cloudn1ne/Mowgli/Mounting/README.md

## Mounting hardware inside the Bot

### Raspberry Pi 4

* [Raspi 4 Mount STL + Images](./Raspi)

### Meanwell NID65-5 DCDC

* [DCDC Converter mount and wiring](./DCDC)

### UBlox Antenna for RTK GPS
(note that i removed the magnet from the base, to make life easier for the IMUs magnetometer - see pictures in the folder)
You can use the drill template (PDF) with an Eurocard singled sided copper PCB (100x160mm)

* [UBlox GPS Antenna + Drill Template](./GPS%20Antenna)

### Pololu IMU-10-v5

* [IMU Mount STL + Images](./IMU)

### ST-Link

* [ST Link Mount STL + Image](./STLink)

### Cameras (optional)

* [Fish Eye Raspi Cam](./Cam)
* [alternative Fish Eye Raspi Cam](./Cam%20alternative)

## Overview
