cloudn1ne/Mowgli/FlowCharts/README.md

# Mowgli Behavior Flow Charts

You can use [Draw.IO](https://draw.io) to view those files.
