cloudn1ne/Mowgli/Kicad/README.md

## System Architecture 

This Kicad project tracks the system architecture of the GForce mainboard, note that there a sub sheets for every major component on the mainboard.

[Here](https://www.re-innovation.co.uk/docs/multiple-sheet-schematics-in-kicad/) is how that works in case you never used that before.
