cloudn1ne/Mowgli/Mounting/Cam alternative/README.md

## Cam mount (alternative with bigger cam module)

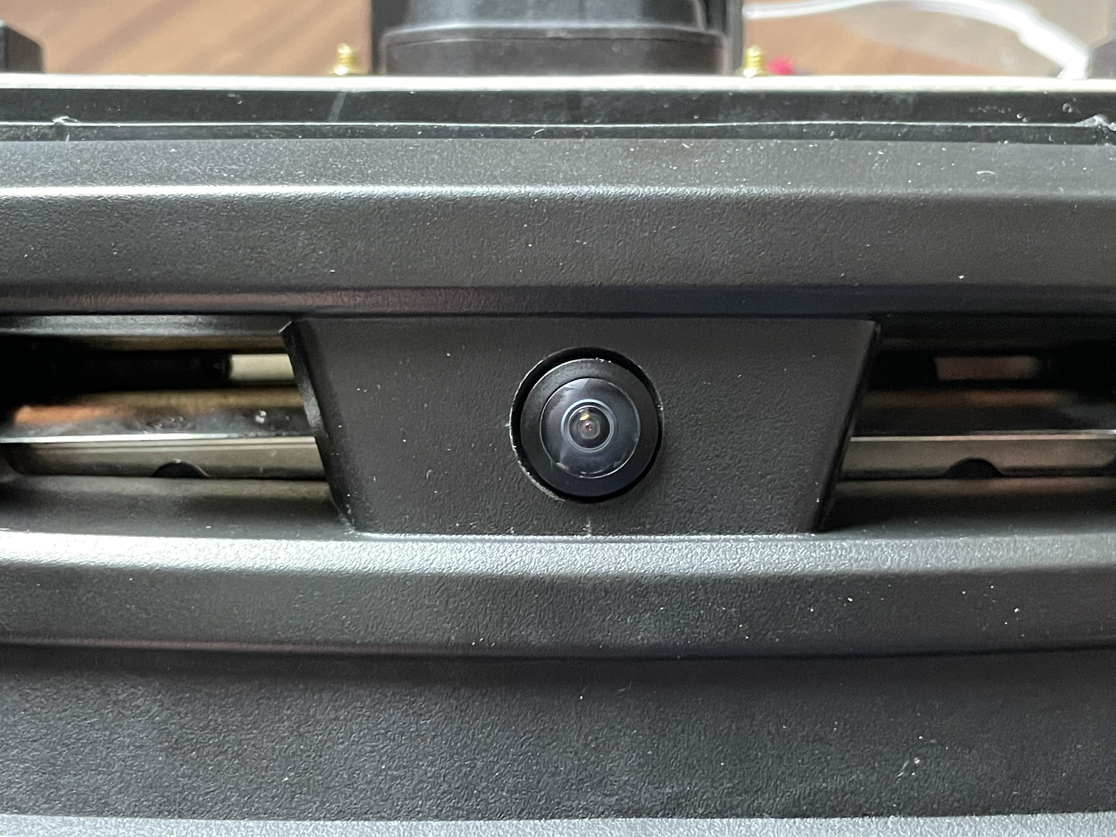
[picture p5: Mounting/Cam alternative/cam_mounted.jpeg]


## Assembly

Used camera was: https://www.amazon.de/gp/product/B074W6TPHF 
(don't forget to additionally purchase a ~50cm camera cable as the one that comes with the camera is just 15cm. I used this one: https://www.amazon.de/gp/product/B01MU2HAOM)

You will need a Dremel tool to slit the case to allow the flat cable to pass through and a 14mm drill for the camera lens to fit through the insert. To mount the camera with the insert to the mount you'll need some M2x14 screws and nuts.

Note that you can remove the whole insert to make drilling and assembly easier.

* Parts

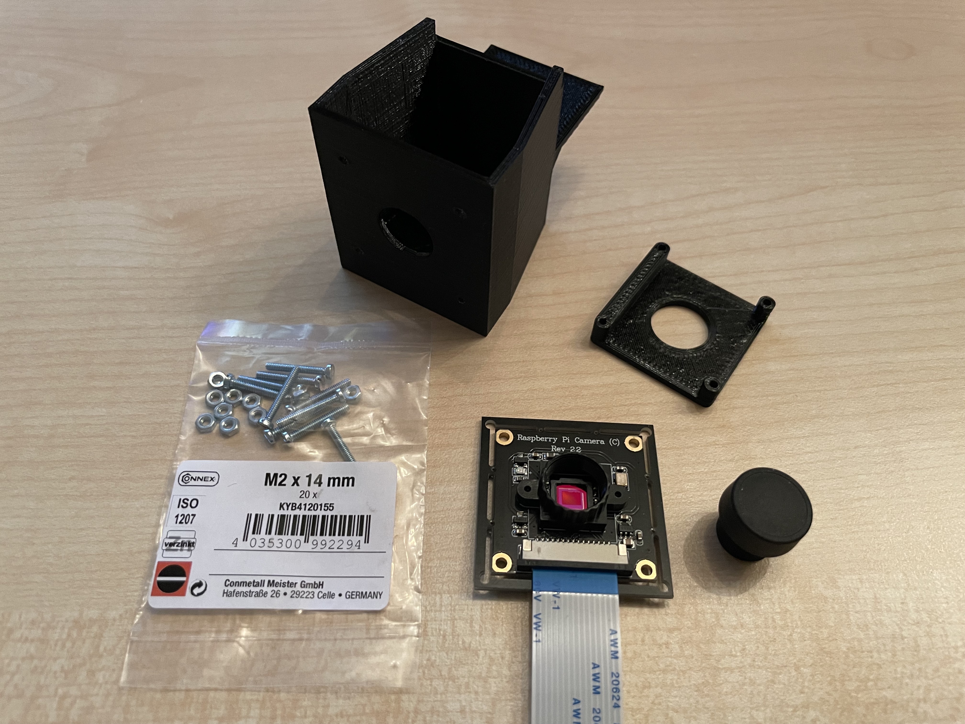
[picture p6: Mounting/Cam alternative/cam_parts.jpeg]


* Mount cam in insert

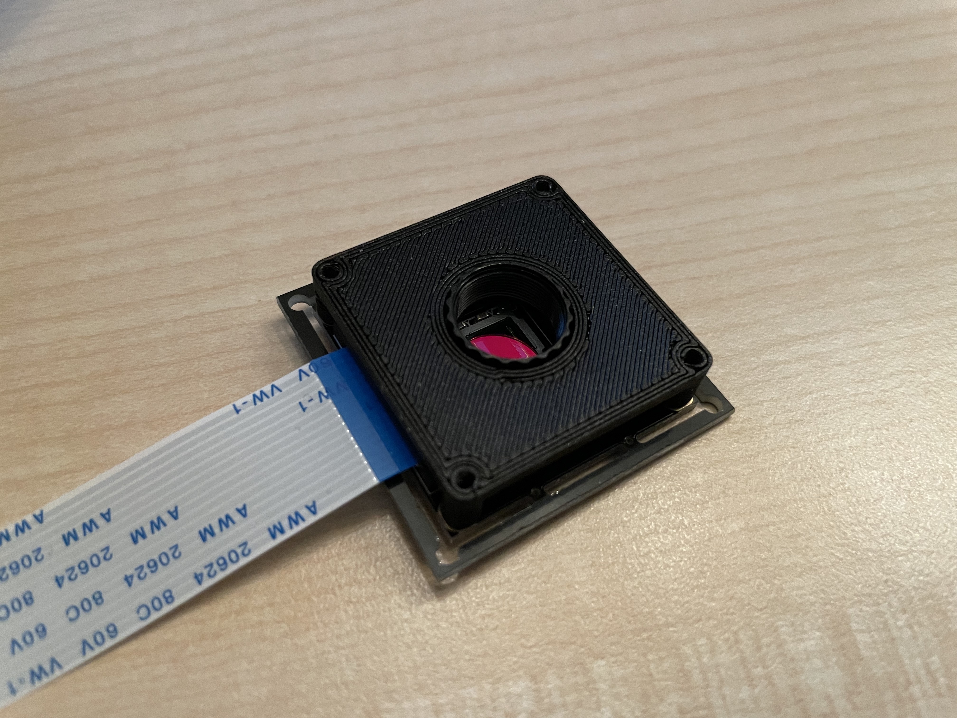
[picture p7: Mounting/Cam alternative/cam_insert.jpeg]


* Mount insert with cam in mount

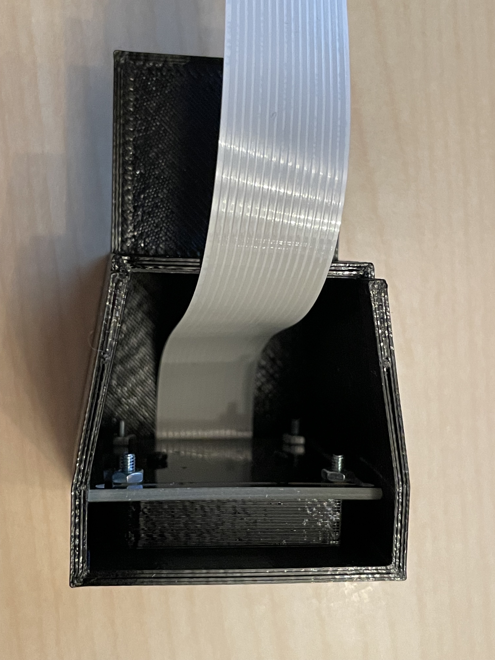
[picture p8: Mounting/Cam alternative/cam_insert_and_mount.jpeg]

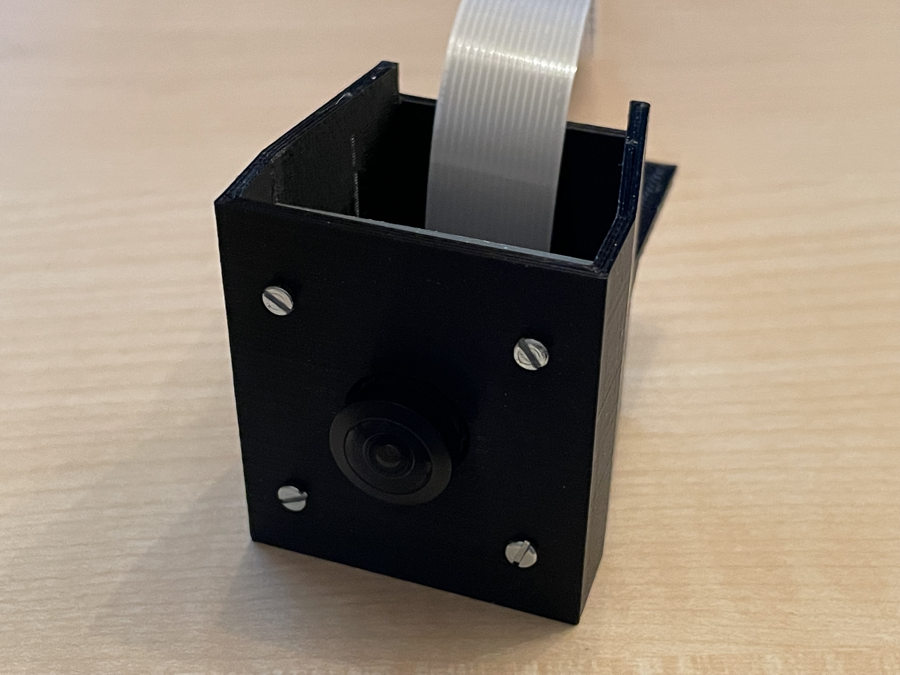
[picture p9: Mounting/Cam alternative/cam_complete.jpeg]


* Make slot with Dremel tool for flat cable

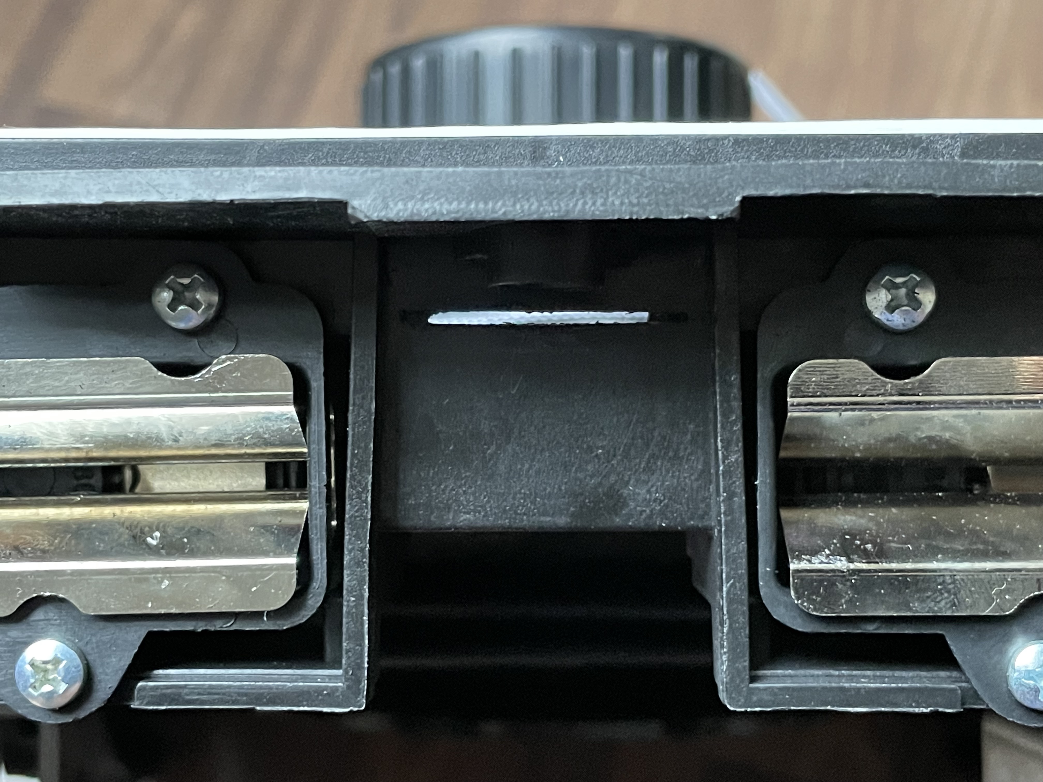
[picture p10: Mounting/Cam alternative/cam_yf500_slot.jpeg]


* Drill out insert with 14mm drill for camera lens

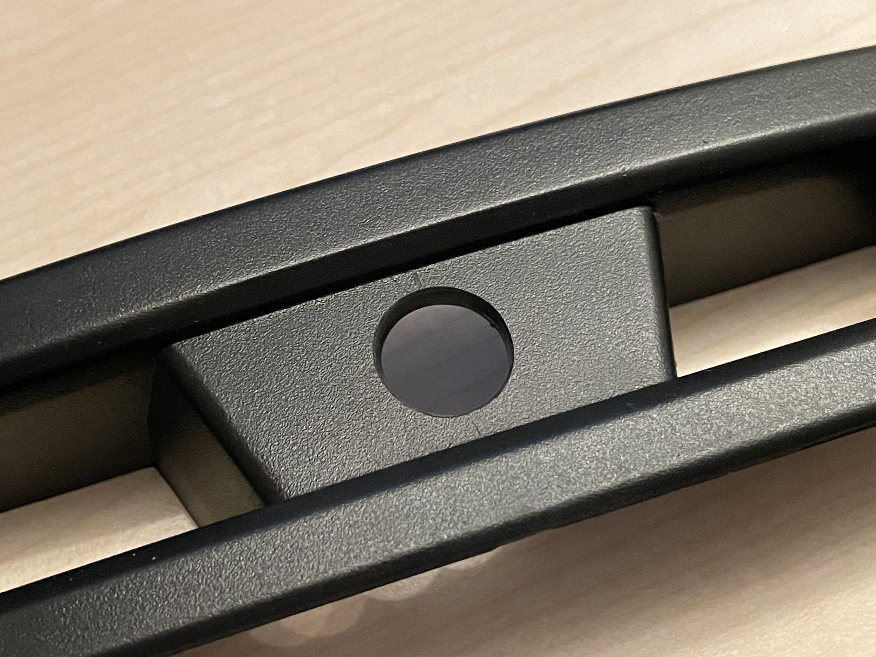
[picture p11: Mounting/Cam alternative/cam_yf500_drill.jpeg]


* Route flat cable through slot to Raspi

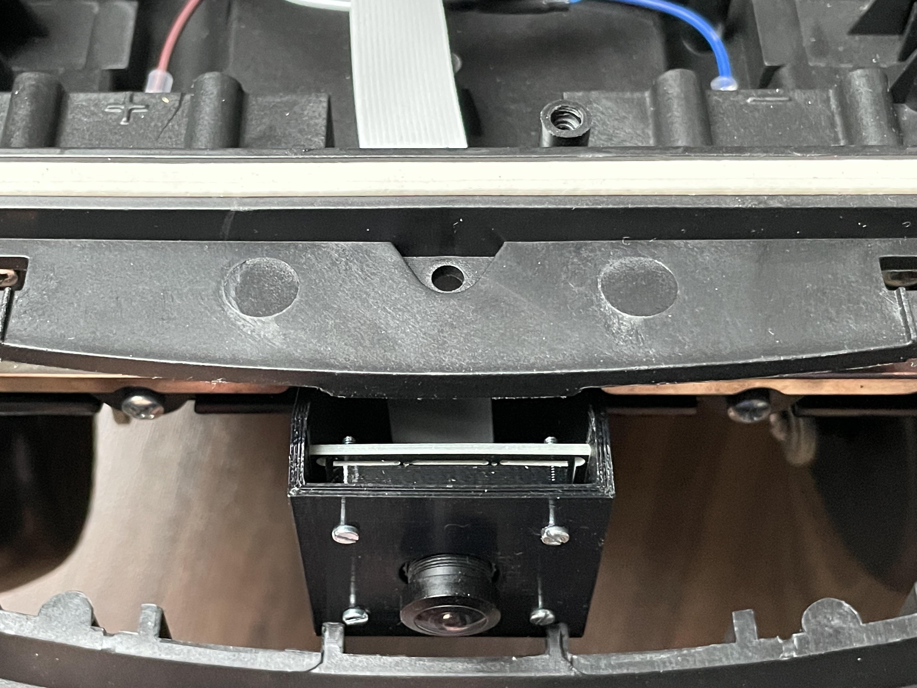
[picture p12: Mounting/Cam alternative/cam_cable_routing.jpeg]
