cloudn1ne/Mowgli/Mounting/Cam/README.md

## Cam mount

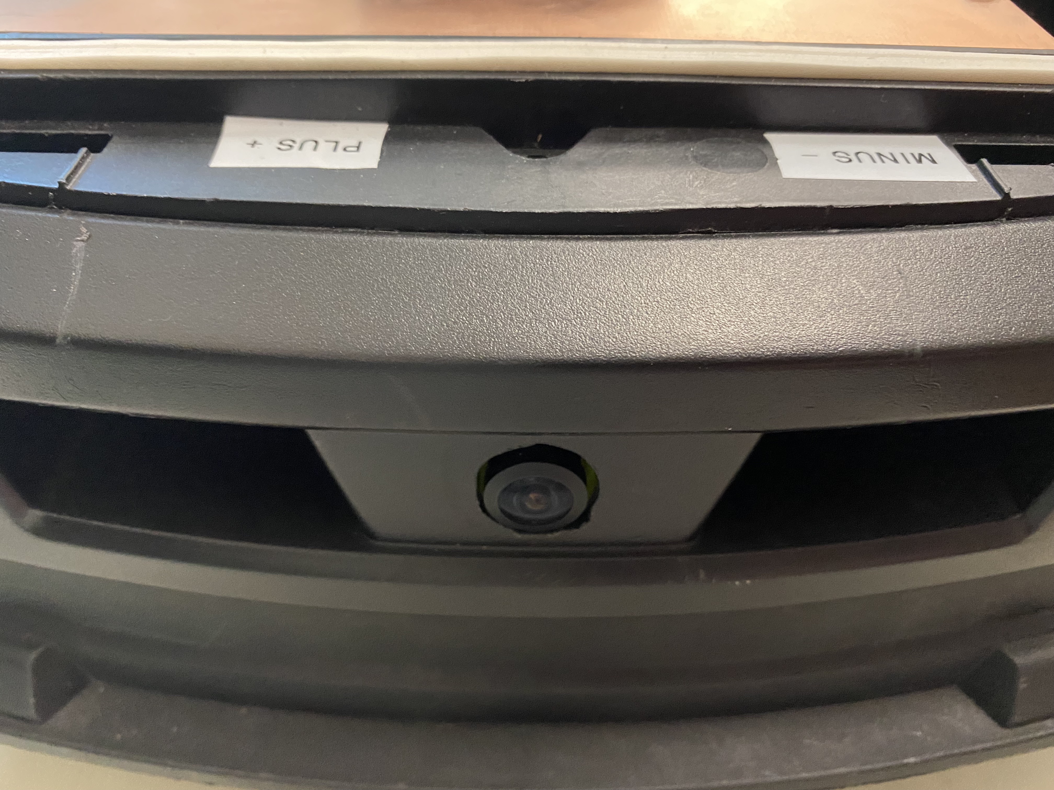
[picture p13: Mounting/Cam/cam_mounted.jpg]


## Assembly

Used camera was: https://www.amazon.com/SainSmart-Fish-Eye-Camera-Raspberry-Arduino/dp/B00N1YJKFS

(For an alternative mount for bigger cam modules see [here](../Cam%20alternative/))

You will need a dreml to slit the case to allow the flat flex to pass through and a 14mm drill

Note that you can remove the whole insert to make drilling and assembly easier.

* Mount cam in insert

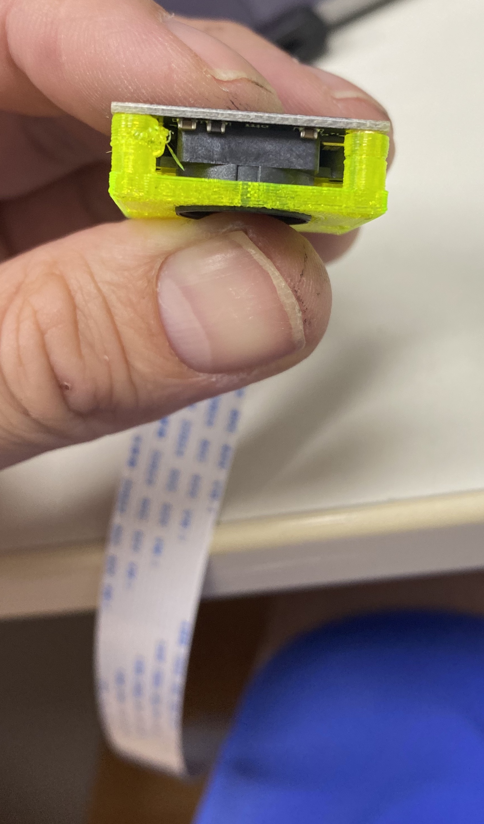
[picture p14: Mounting/Cam/cam_insert.jpg]


* Mount insert in mount

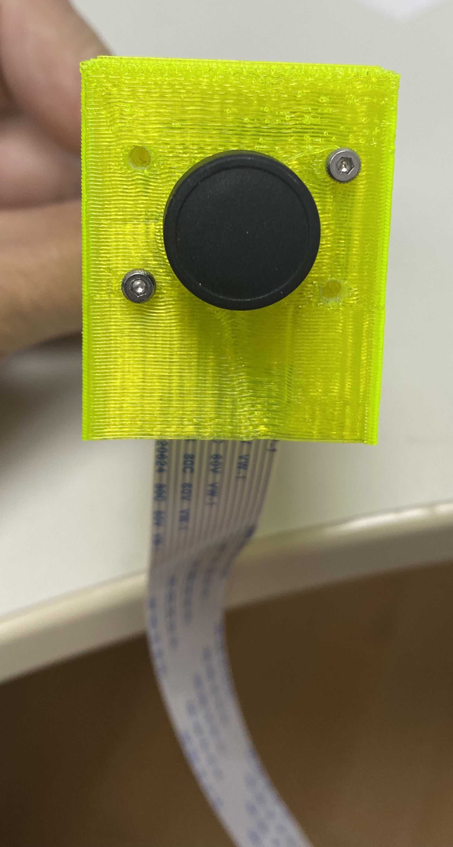
[picture p15: Mounting/Cam/cam_insert_and_mount2.jpg]

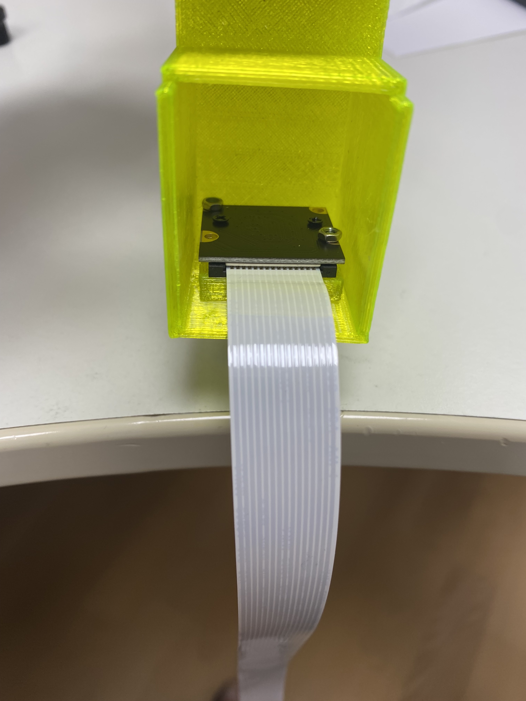
[picture p16: Mounting/Cam/cam_insert_and_mount1.jpg]


* Make slit with dremel for flatflex
* Route flatflex to raspi

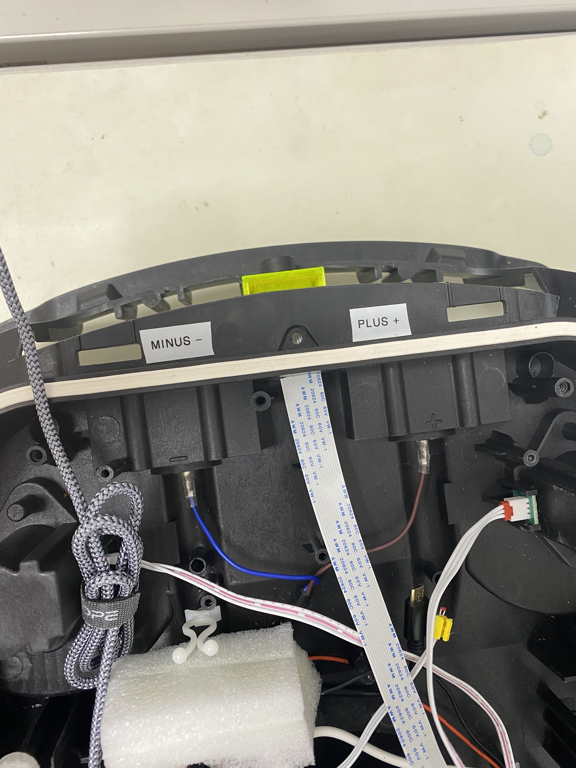
[picture p17: Mounting/Cam/cam_cable_routing.jpg]
