cloudn1ne/Mowgli/Mounting/GPS Antenna/README.md

## Mounting

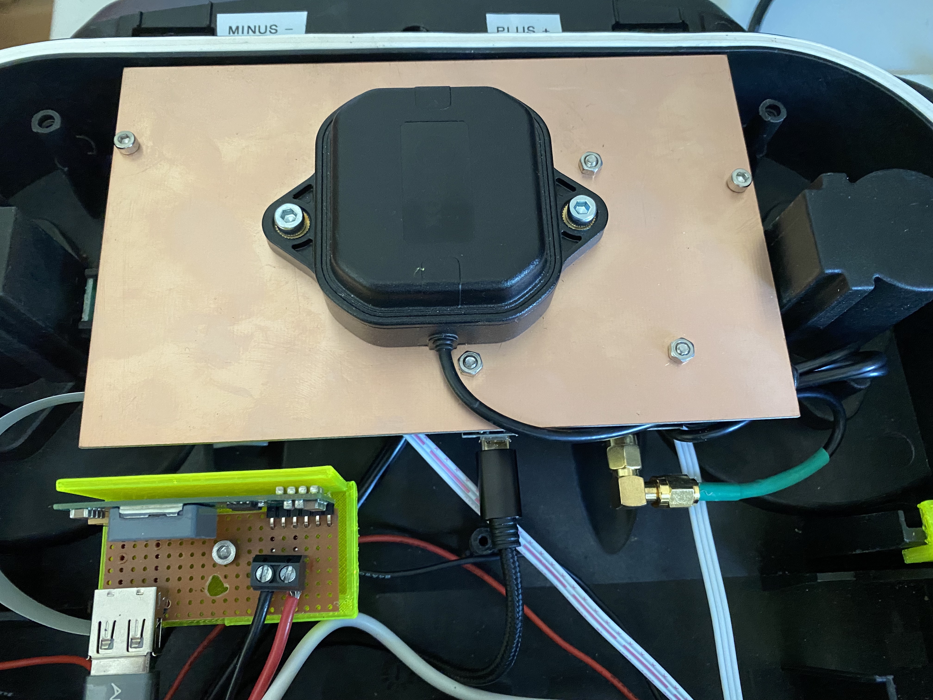
[picture p19: Mounting/GPS Antenna/ublox_mounting.jpg]


## Remove the magnet from the base of the UBlox Antenna

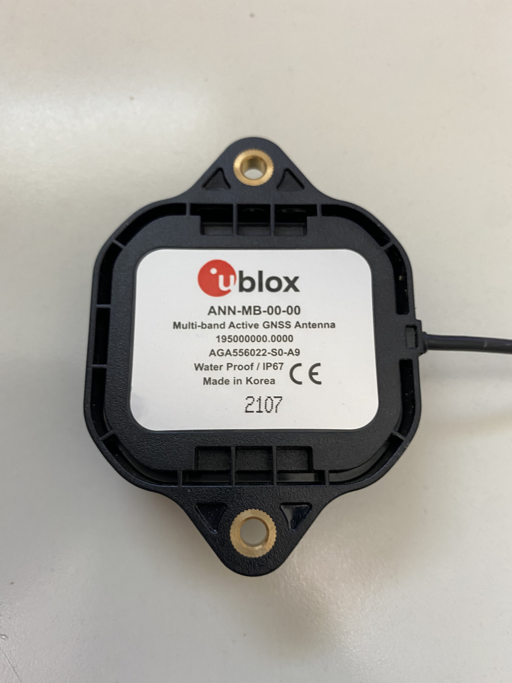
[picture p20: Mounting/GPS Antenna/ublox_mag_removal1.jpg]

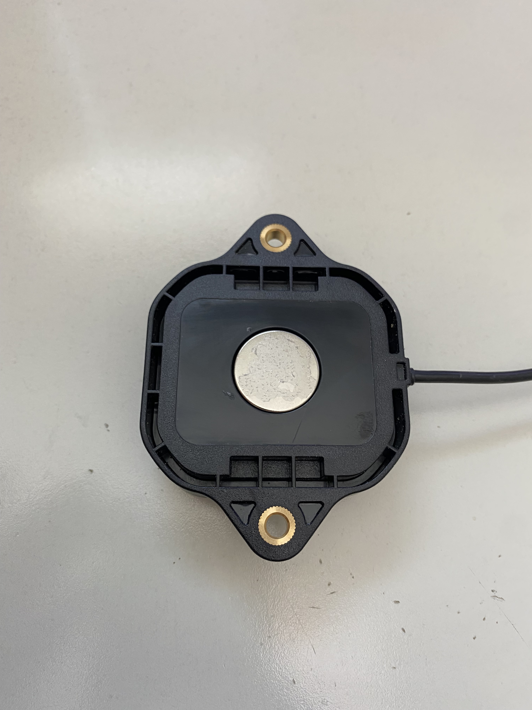
[picture p21: Mounting/GPS Antenna/ublox_mag_removal2.jpg]

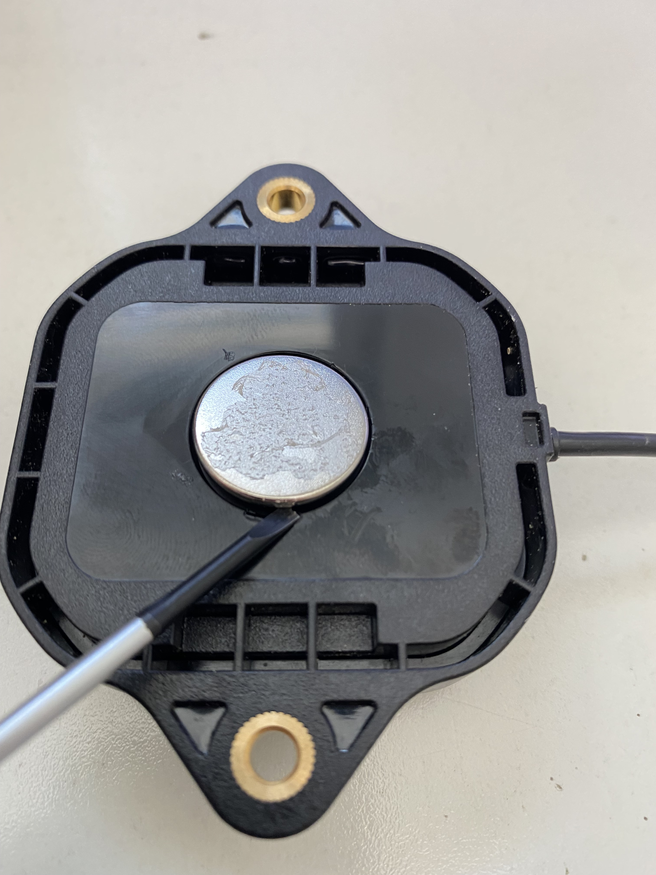
[picture p22: Mounting/GPS Antenna/ublox_mag_removal3.jpg]

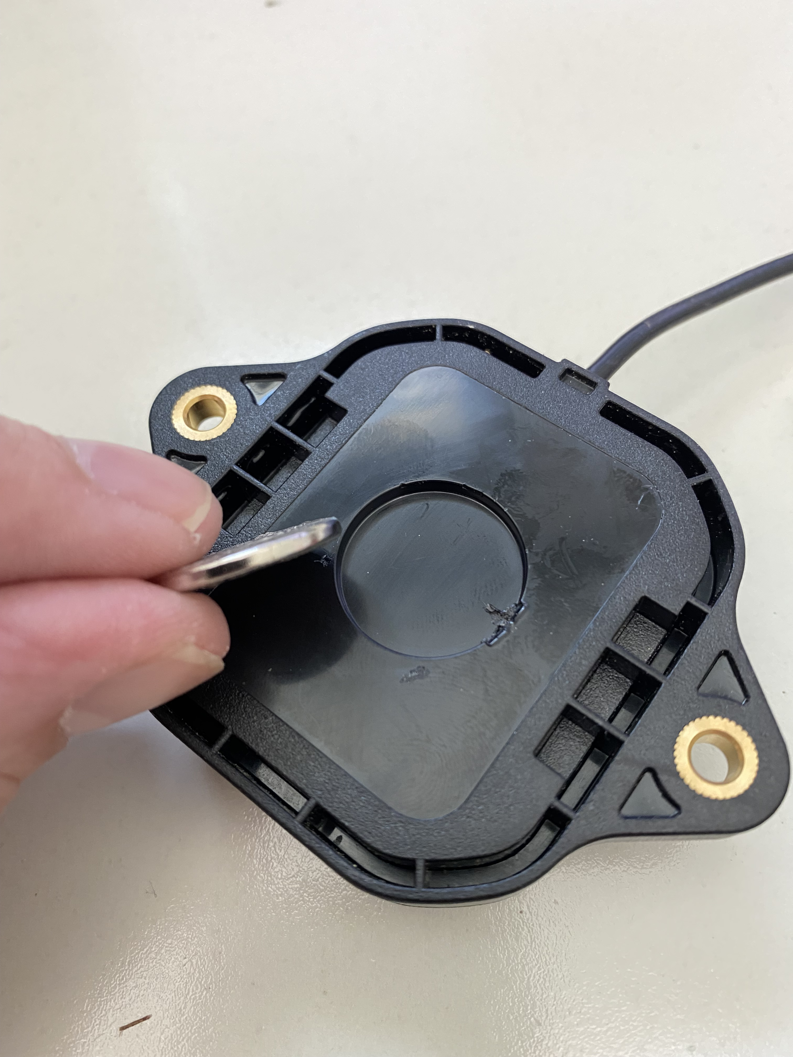
[picture p23: Mounting/GPS Antenna/ublox_mag_removal4.jpg]
