cloudn1ne/Mowgli/Mounting/STLink/README.md

## ST Link mounting

Be carefull when you close the lid, it is a tight fit

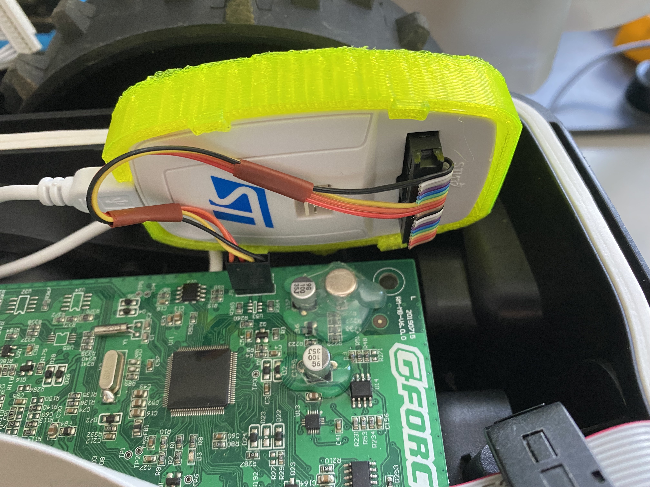
[picture p24: Mounting/STLink/stlink_mounted.jpg]
