cloudn1ne/Mowgli/Mounting/IMU/README.md

## External (Debug) Serial & optionally IMU

## Refurbish the existing sensor board cable shown here:

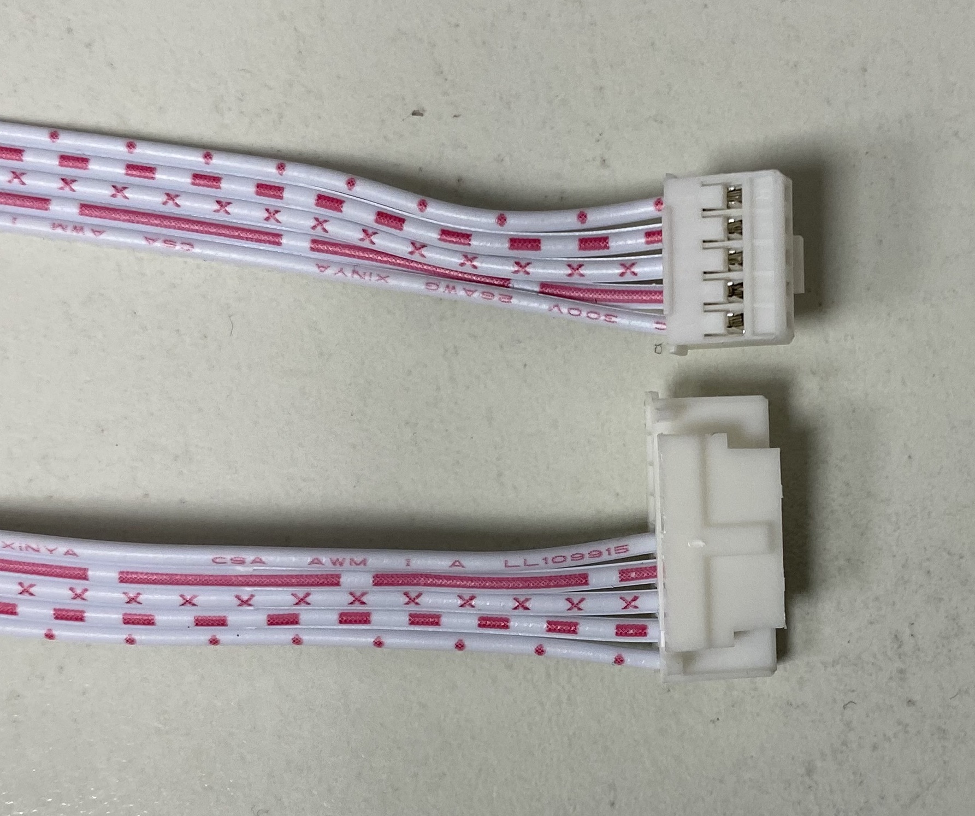
[picture p25: Mounting/IMU/serial_and_i2c_orig.jpg]


## And refactor to an Debug and IMU (I2C) cable:

You will need to relocate the pins using a sharp pick tool (gently lift the small plastic tab, then you can extract the individual crimp pins, slide them into the new position until u hear an audible click)

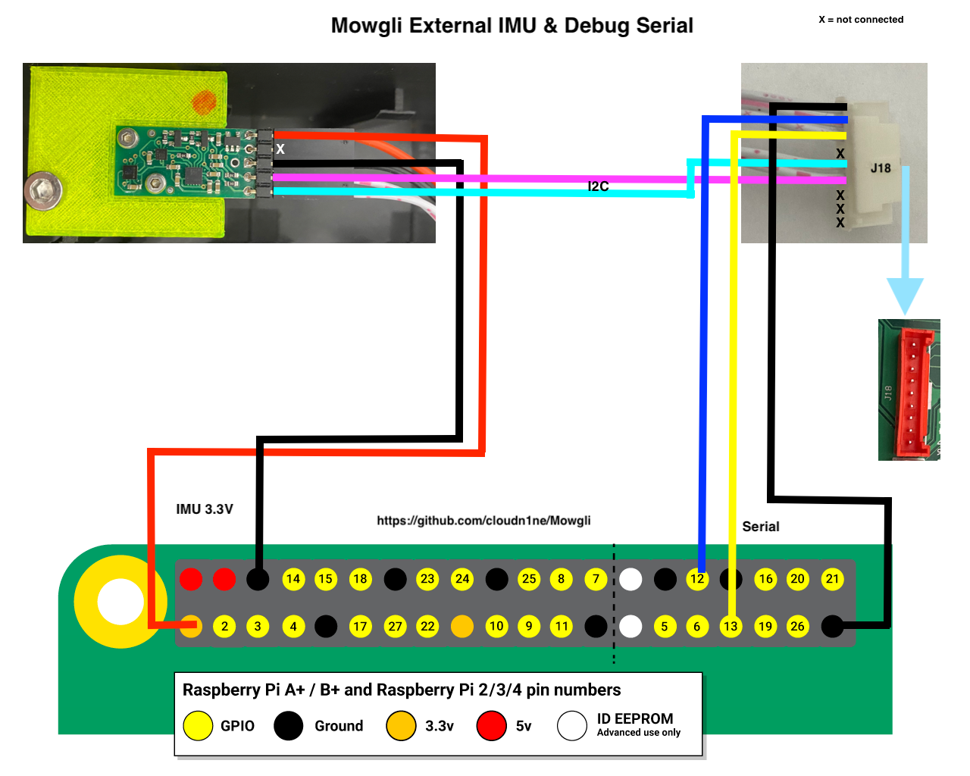
[picture p26: Mounting/IMU/serial_and_i2c_mowgli.png]


If you do not need the I2C IMU you can obmit those cables, and just connect Black (GND), Blue (TX), Yellow (RX) to the Raspi GPIO header

## IMU Mounting location
