cloudn1ne/Mowgli/Datasheets/Mowgli_Battery.png

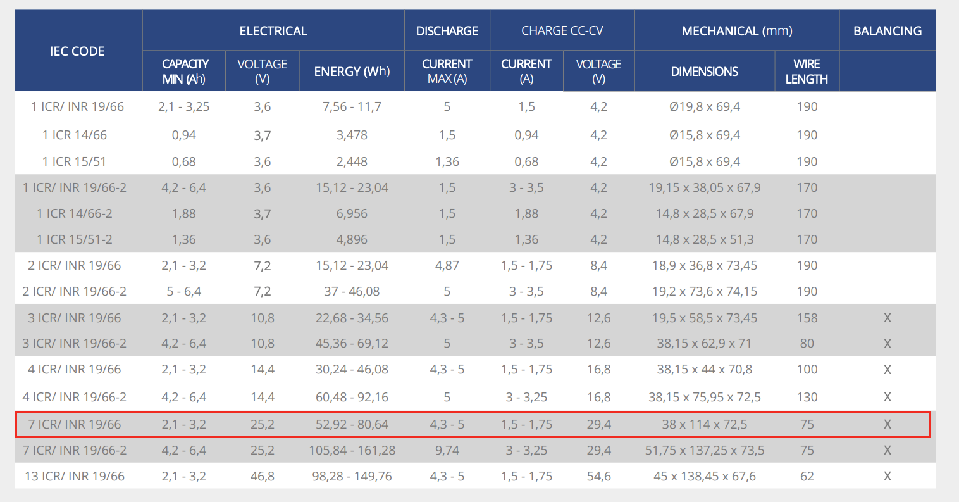
Datasheets/Mowgli_Battery.png
