cloudn1ne/Mowgli/Datasheets/Tools/FTDI-cable-pinout-diagram.jpeg

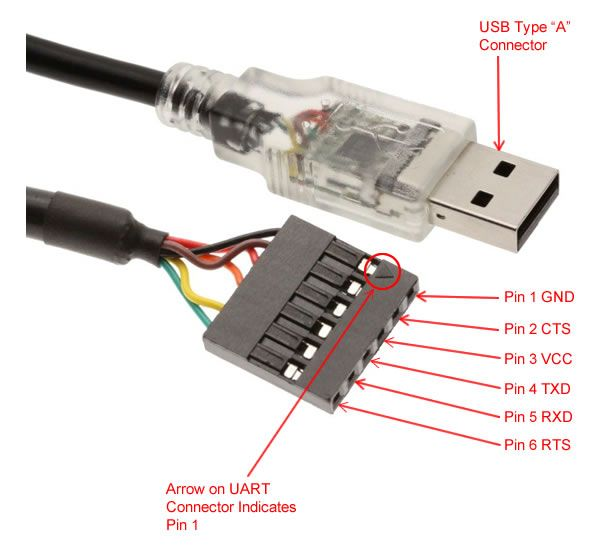
Datasheets/Tools/FTDI-cable-pinout-diagram.jpeg
