cloudn1ne/Mowgli/FlowCharts/png/MowgliArch_v1.0.1.png

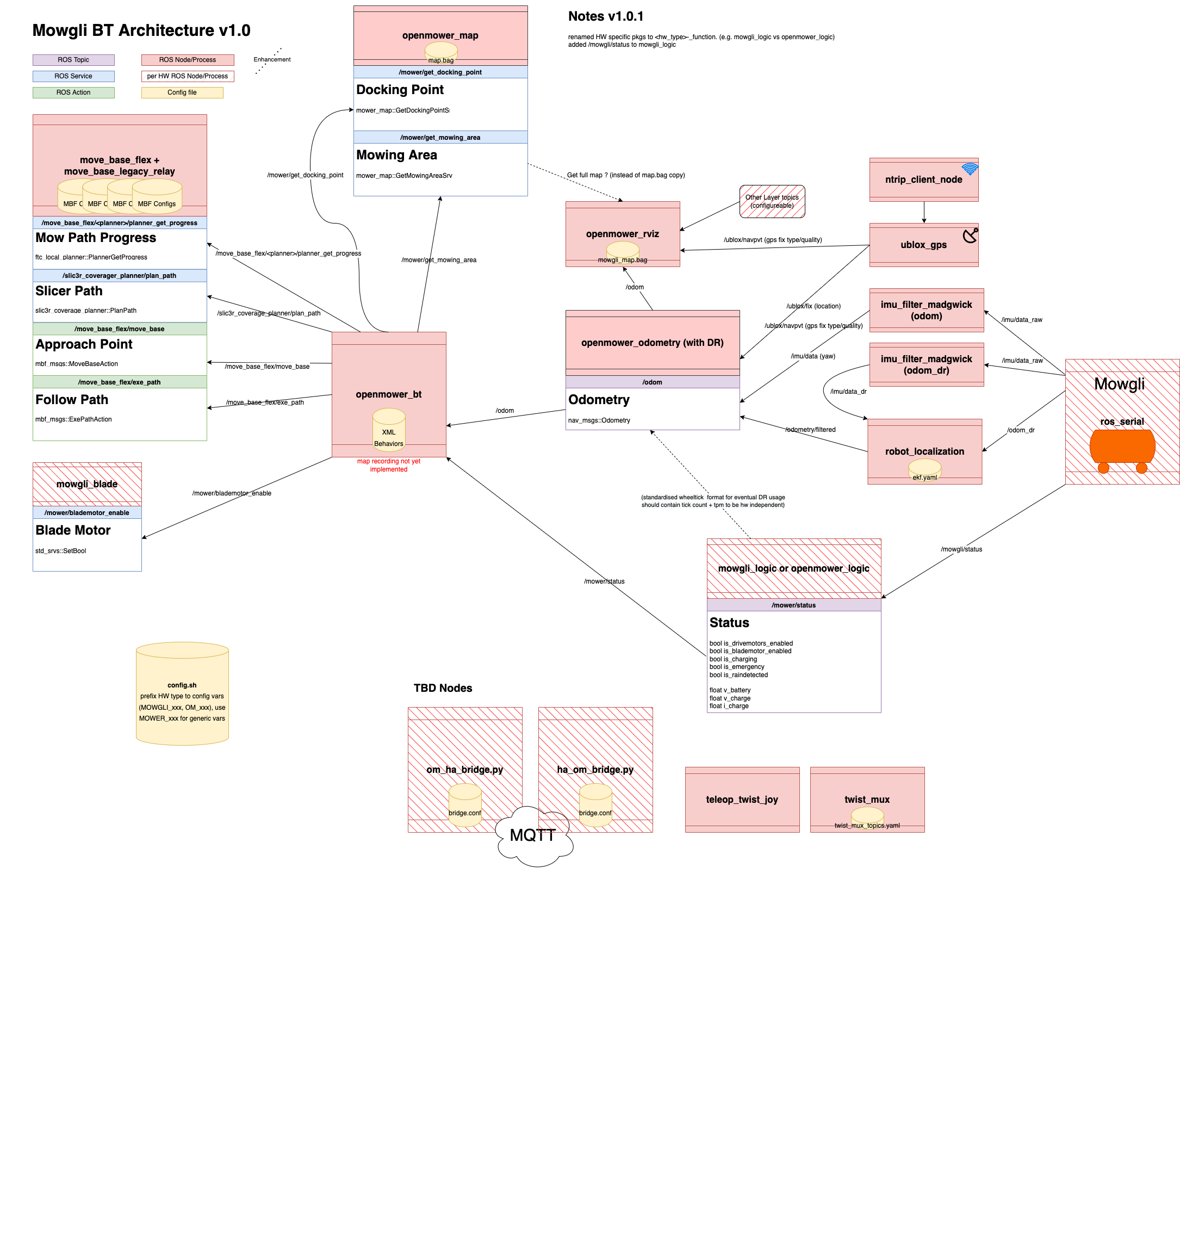
FlowCharts/png/MowgliArch_v1.0.1.png
