cloudn1ne/Mowgli/FlowCharts/png/MowgliArch_v1.0.2.png

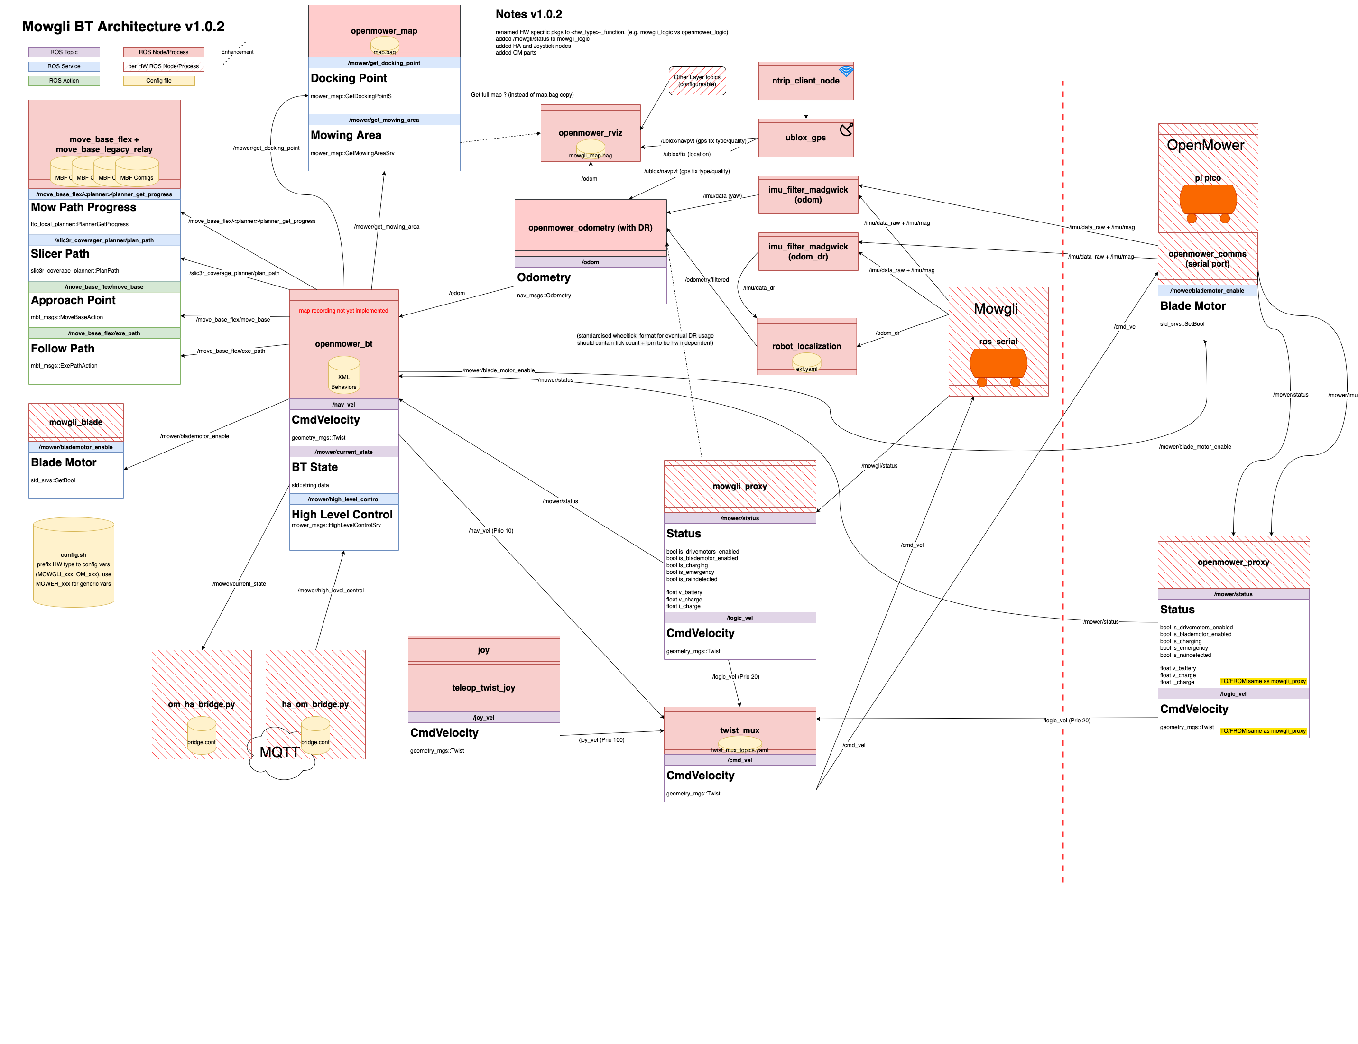
FlowCharts/png/MowgliArch_v1.0.2.png
