cloudn1ne/Mowgli/images/accelerometer_axis.jpg

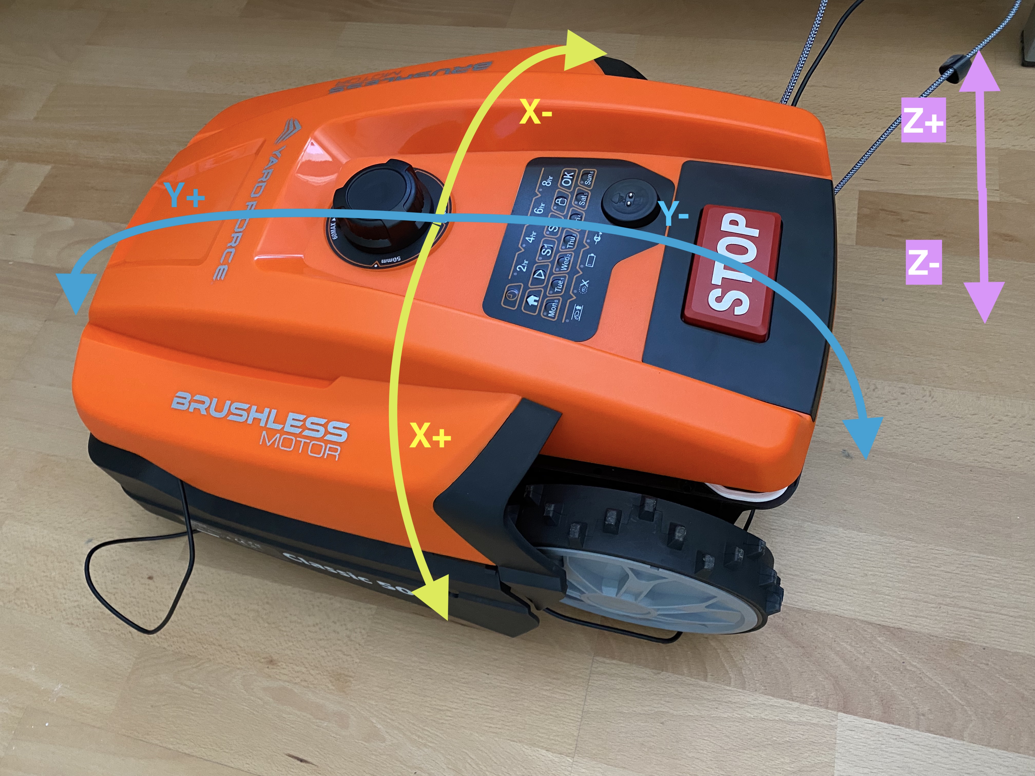
images/accelerometer_axis.jpg
