cloudn1ne/Mowgli/images/battery/IMG_3641.jpg

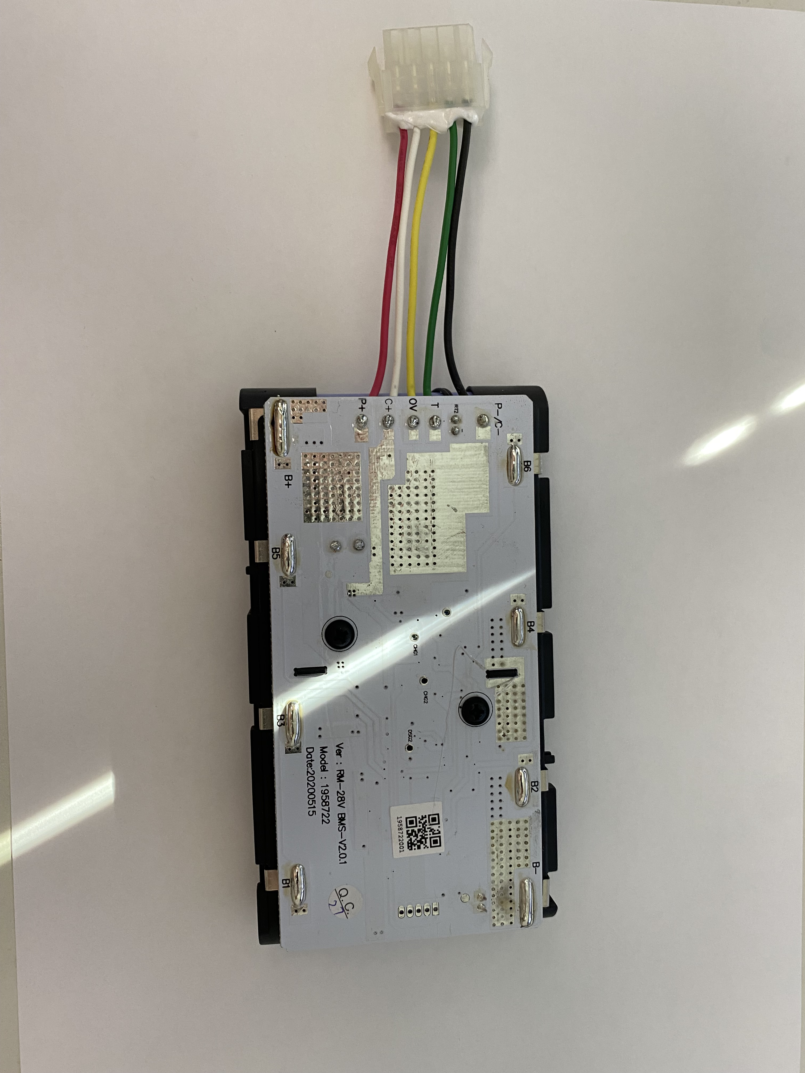
images/battery/IMG_3641.jpg
