cloudn1ne/Mowgli/images/battery/IMG_3642.jpg

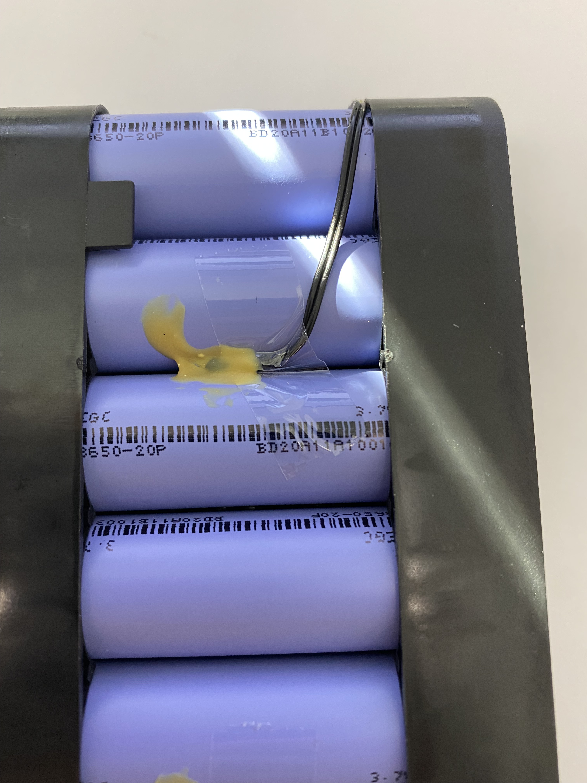
images/battery/IMG_3642.jpg
