cloudn1ne/Mowgli/images/battery/IMG_3643.jpg

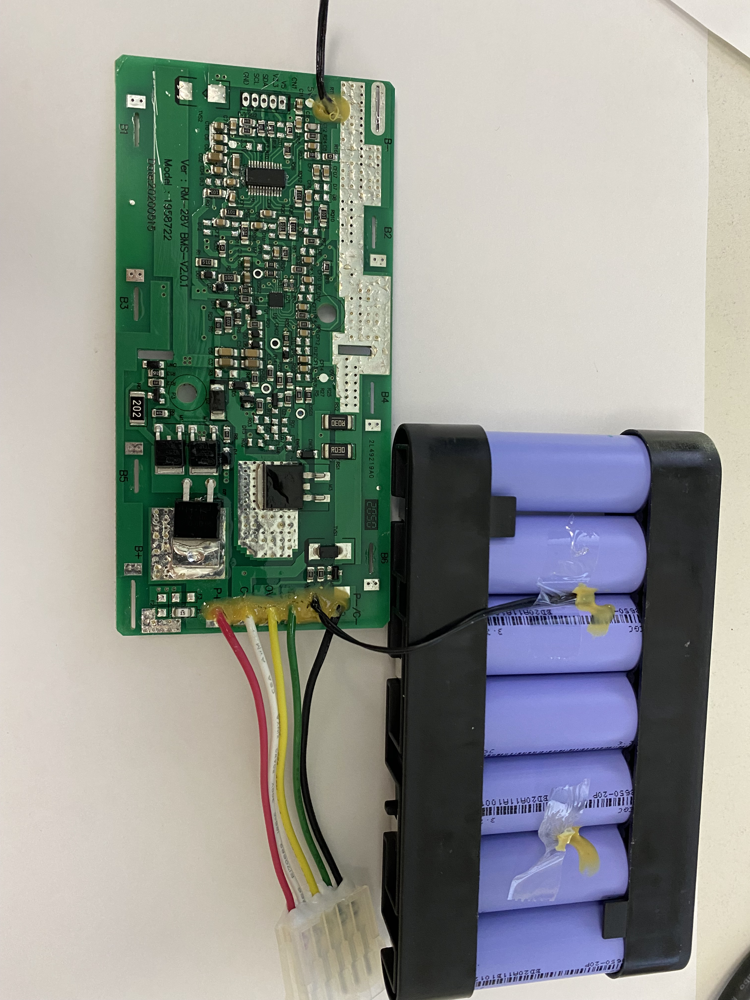
images/battery/IMG_3643.jpg
