cloudn1ne/Mowgli/images/battery/IMG_3644.jpg

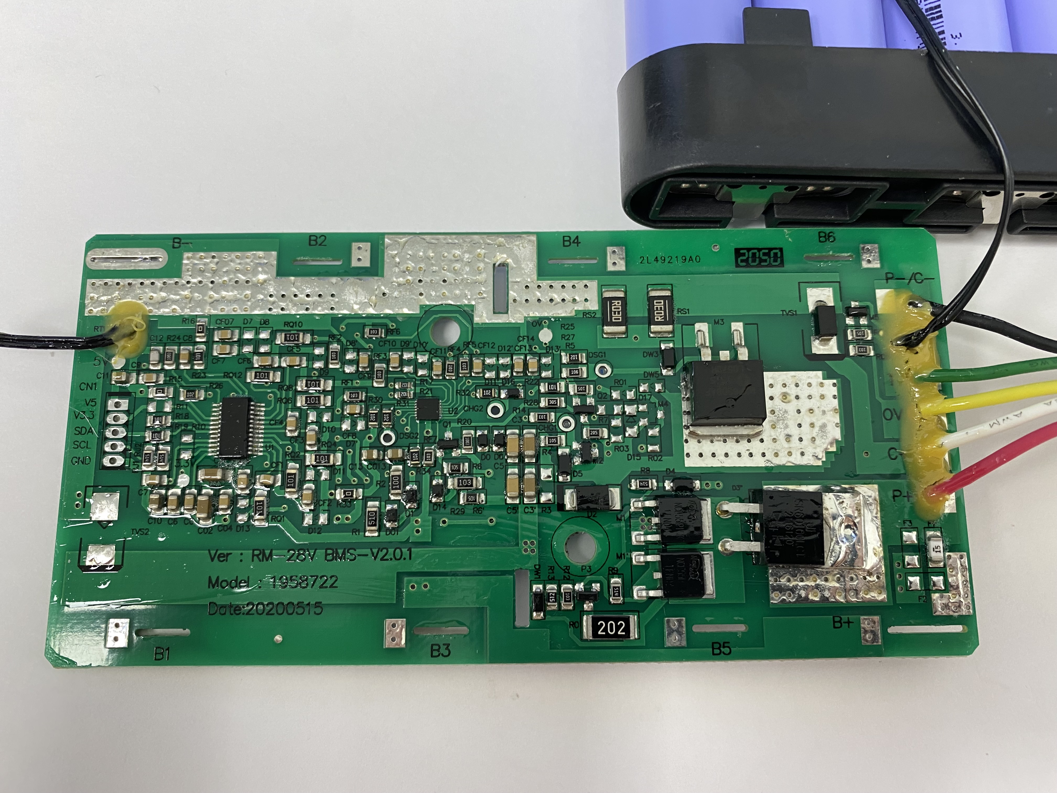
images/battery/IMG_3644.jpg
