cloudn1ne/Mowgli/images/battery/IMG_3645.jpg

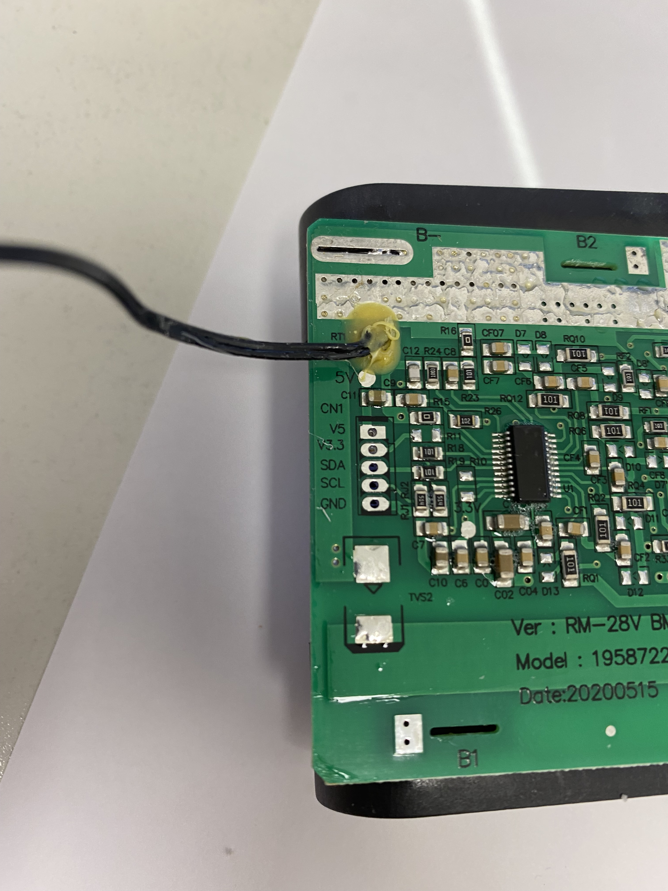
images/battery/IMG_3645.jpg
