cloudn1ne/Mowgli/images/battery/IMG_3647.jpg

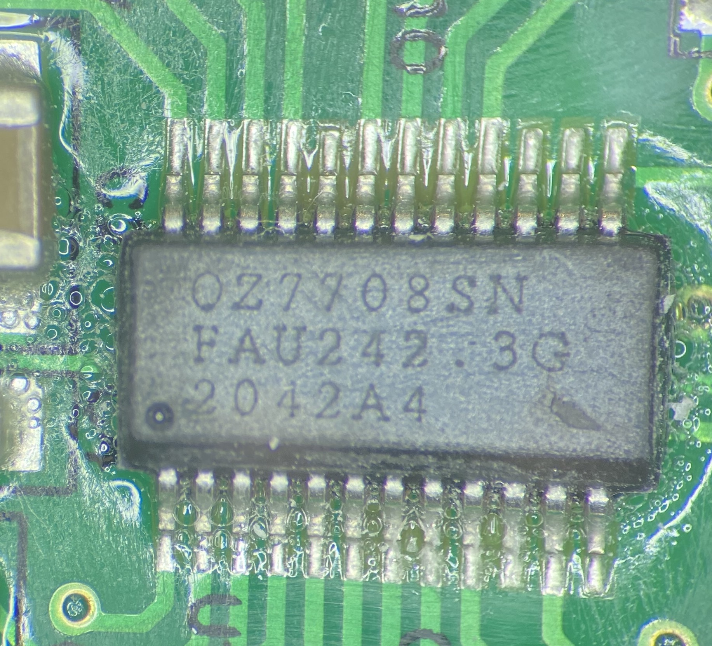
images/battery/IMG_3647.jpg
