cloudn1ne/Mowgli/images/battery/IMG_3648.jpg

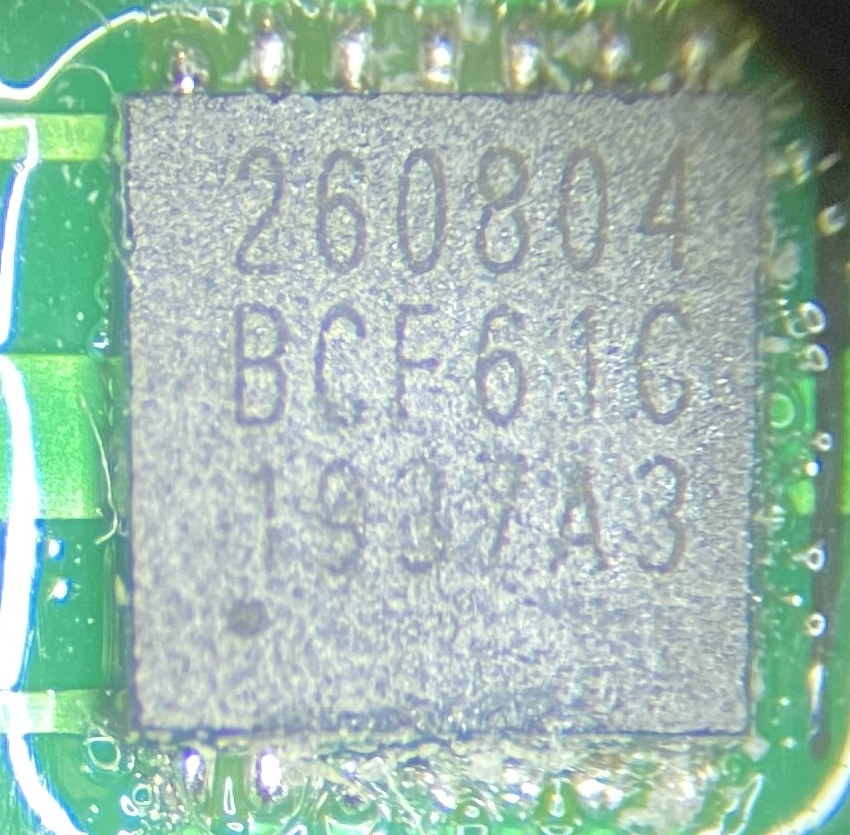
images/battery/IMG_3648.jpg
