cloudn1ne/Mowgli/Mounting/IMU/imu_carrier1.jpg

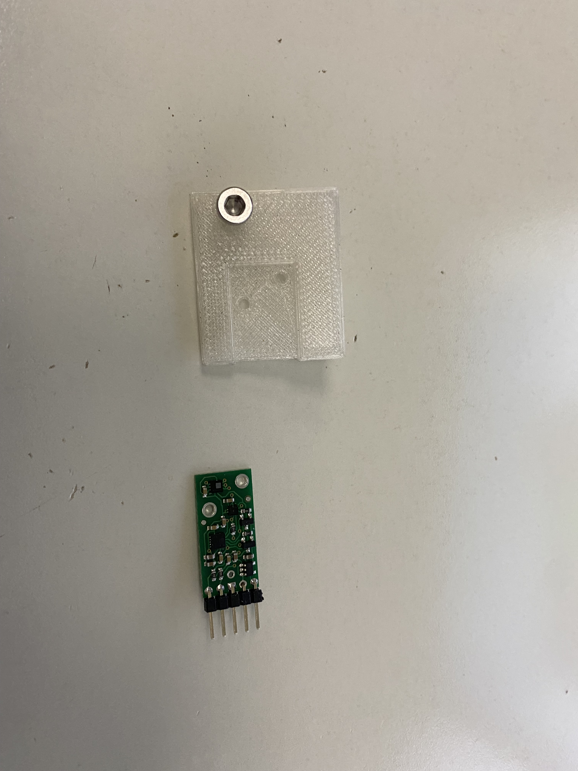
Mounting/IMU/imu_carrier1.jpg
