cloudn1ne/Mowgli/Mounting/IMU/imu_carrier2.jpg

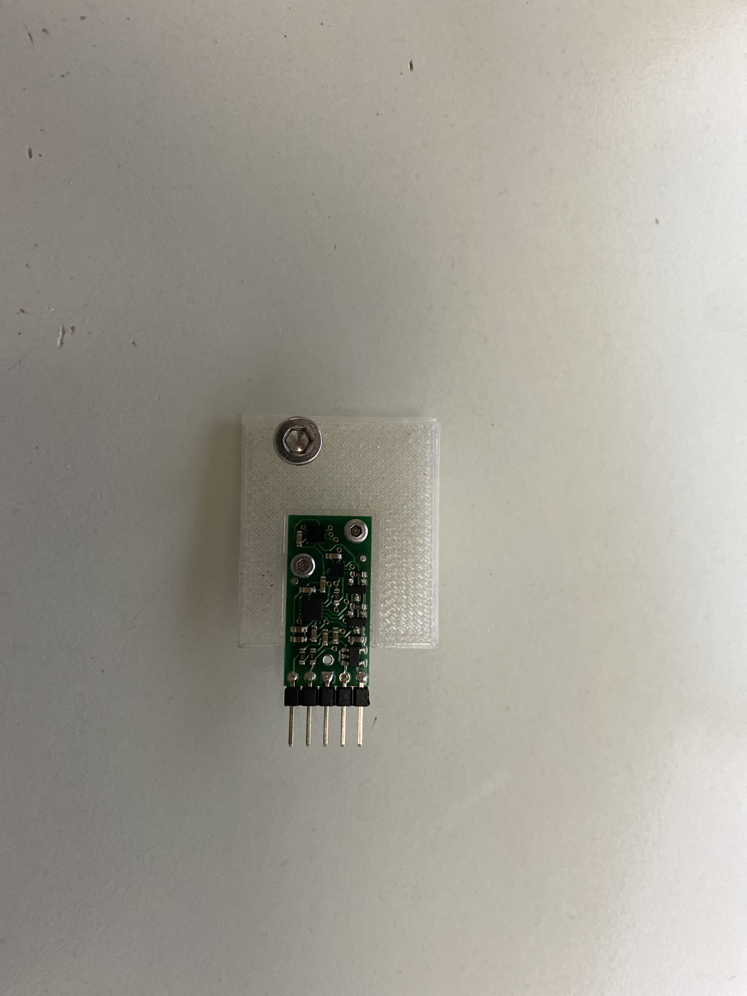
Mounting/IMU/imu_carrier2.jpg
