cloudn1ne/Mowgli/Mounting/Raspi/raspi_mount1.jpg

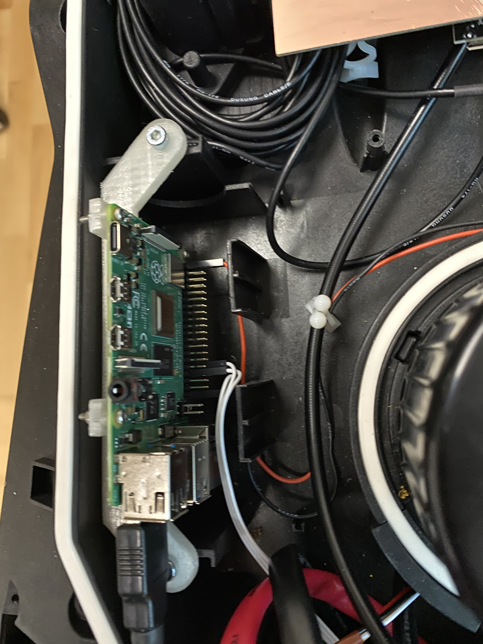
Mounting/Raspi/raspi_mount1.jpg
