cloudn1ne/Mowgli/Mounting/Cam alternative/Raspi Big Camera Mount YF500 Insert.stl

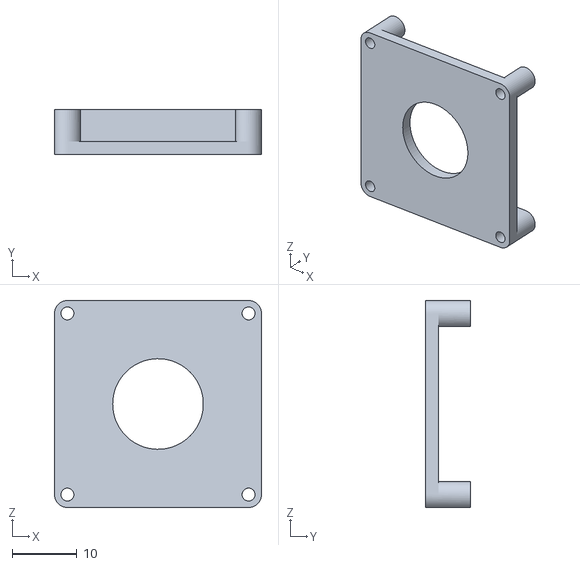
[picture p46: CAD file, 2022-10-02]
Mounting/Cam alternative/Raspi Big Camera Mount YF500 Insert.stl
32.0 x 7.00 x 32.0
