cloudn1ne/Mowgli/Mounting/Cam/Raspi Camera Mount YF500 Insert.stl

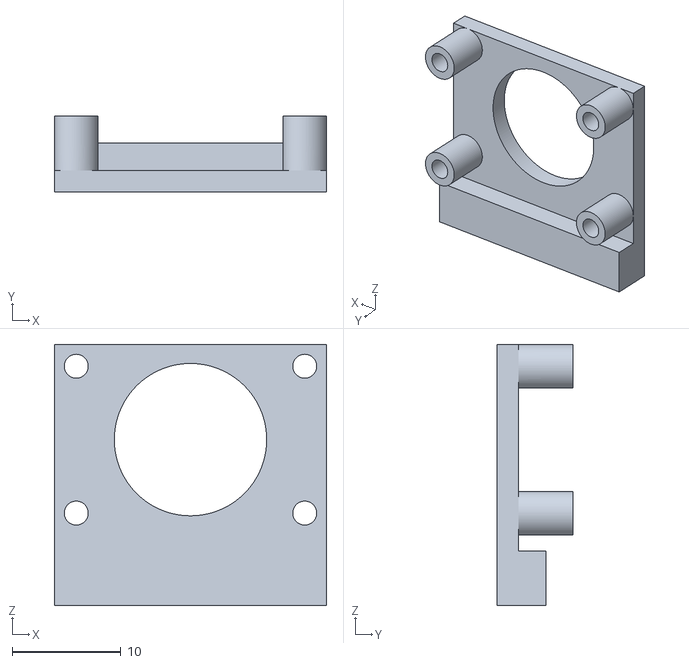
[picture p47: CAD file, 2022-07-03]
Mounting/Cam/Raspi Camera Mount YF500 Insert.stl
25.0 x 7.00 x 24.0
