cloudn1ne/Mowgli/Mounting/DCDC/MeanWell-DCDC-Converter.stl

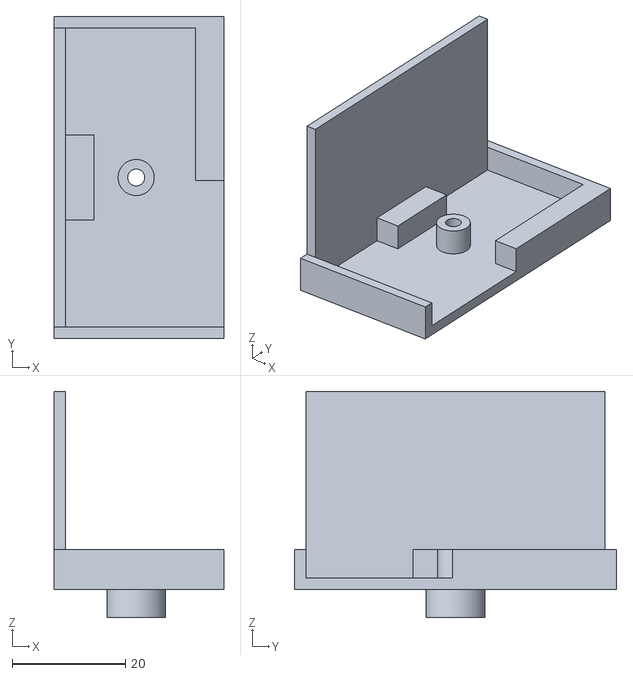
[picture p48: CAD file, 2022-06-22]
Mounting/DCDC/MeanWell-DCDC-Converter.stl
30.0 x 57.0 x 40.0
