cloudn1ne/Mowgli/Mounting/IMU/IMU10v5CarrierYF500.stl

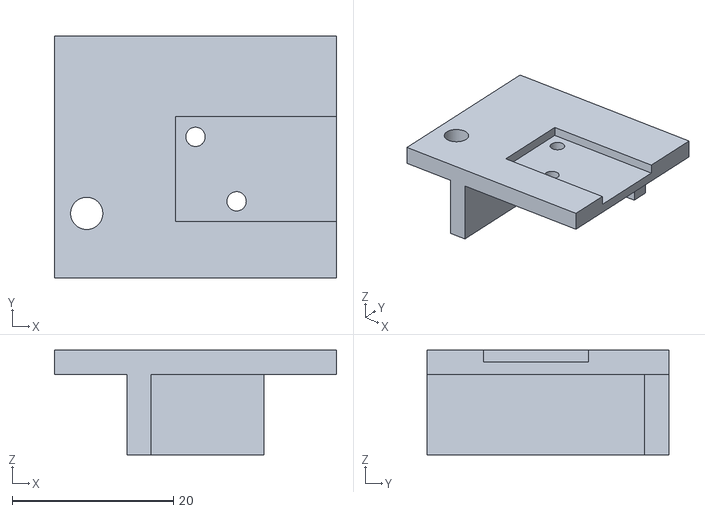
[picture p49: CAD file, 2022-06-24]
Mounting/IMU/IMU10v5CarrierYF500.stl
35.0 x 30.0 x 13.0
