cloudn1ne/Mowgli/Mounting/Raspi/Raspi Brace.stl

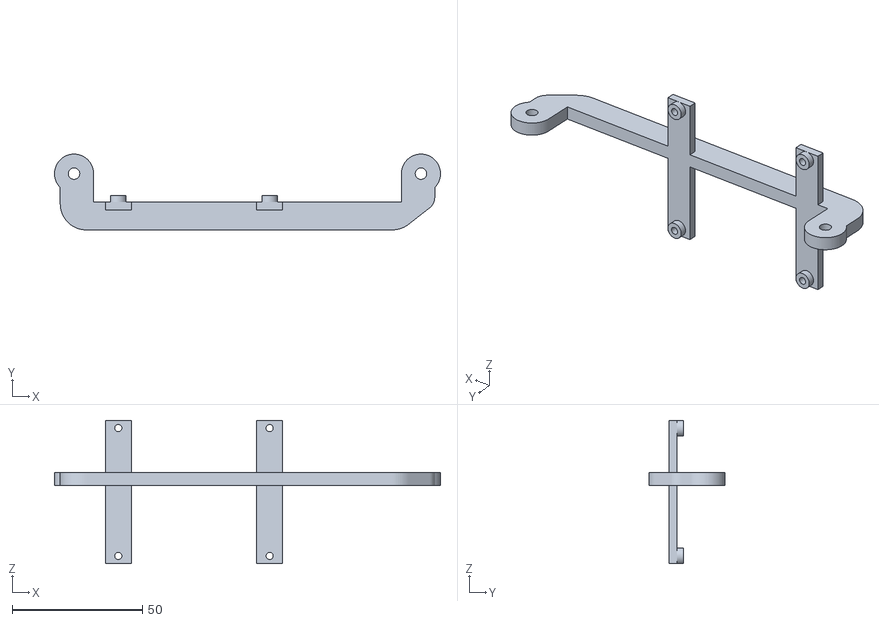
[picture p50: CAD file, 2022-06-22]
Mounting/Raspi/Raspi Brace.stl
148.0 x 29.1 x 55.0
