cloudn1ne/Mowgli/Mounting/STLink/Stlink_holder_v6.stl

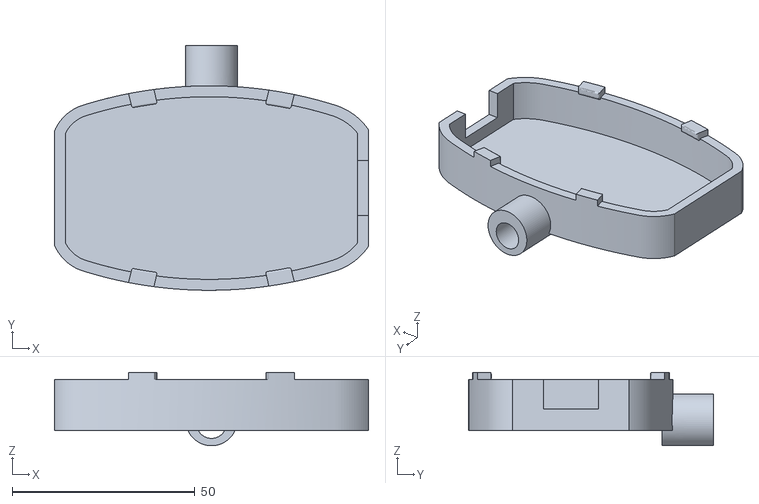
[picture p51: CAD file, 2022-06-30]
Mounting/STLink/Stlink_holder_v6.stl
86.0 x 67.0 x 20.1
