cloudn1ne/Mowgli/Mounting/Cam alternative/Raspi Big Camera Mount YF500.stl

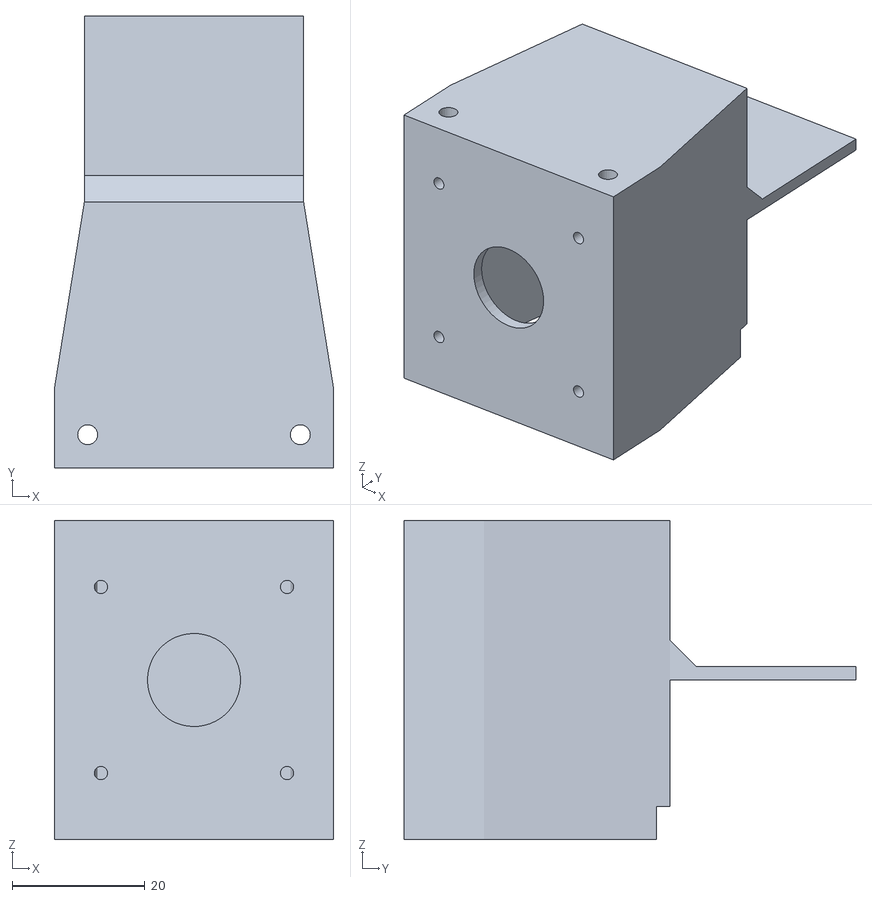
[picture p52: CAD file, 2022-10-02]
Mounting/Cam alternative/Raspi Big Camera Mount YF500.stl
42.0 x 68.0 x 48.0
