cloudn1ne/Mowgli/Mounting/Cam/Raspi Camera Mount YF500.stl

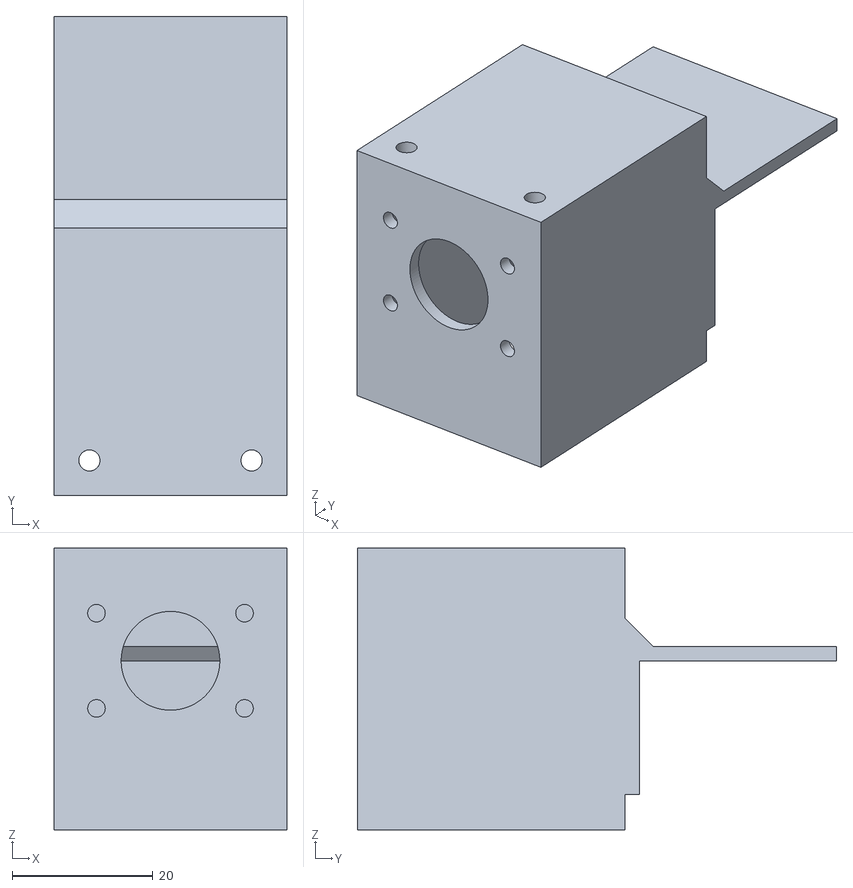
[picture p53: CAD file, 2022-07-03]
Mounting/Cam/Raspi Camera Mount YF500.stl
33.0 x 68.0 x 40.0
