cloudn1ne/Mowgli/imu_scripts/calibration.txt

0.0000092078 0.0000320959 0.0000092078
0.0000092078 0.0000320959 0.0000092078
0.0000087255 0.0000318036 0.0000087255
0.0000087255 0.0000318036 0.0000087255
0.0000086817 0.0000324759 0.0000086817
0.0000085063 0.0000329582 0.0000085063
0.0000085063 0.0000329582 0.0000085063
0.0000089155 0.0000322274 0.0000089155
0.0000089155 0.0000322274 0.0000089155
0.0000091348 0.0000322420 0.0000091348
0.0000091348 0.0000322420 0.0000091348
0.0000085794 0.0000321690 0.0000085794
0.0000085794 0.0000321690 0.0000085794
0.0000089155 0.0000322274 0.0000089155
0.0000089155 0.0000322274 0.0000089155
0.0000087255 0.0000320666 0.0000087255
0.0000087255 0.0000320666 0.0000087255
0.0000080678 0.0000321690 0.0000080678
0.0000080678 0.0000321690 0.0000080678
0.0000085647 0.0000325343 0.0000085647
0.0000085647 0.0000325343 0.0000085647
0.0000083894 0.0000326220 0.0000083894
0.0000083894 0.0000326220 0.0000083894
0.0000088278 0.0000326805 0.0000088278
0.0000088278 0.0000326805 0.0000088278
0.0000083894 0.0000324028 0.0000083894
0.0000083894 0.0000324028 0.0000083894
0.0000087255 0.0000325197 0.0000087255
0.0000087255 0.0000325197 0.0000087255
0.0000089155 0.0000324905 0.0000089155
0.0000089155 0.0000324905 0.0000089155
0.0000091348 0.0000326659 0.0000091348
0.0000091348 0.0000326659 0.0000091348
0.0000085355 0.0000322274 0.0000085355
0.0000082724 0.0000318474 0.0000082724
0.0000082724 0.0000318474 0.0000082724
0.0000085355 0.0000323297 0.0000085355
0.0000085355 0.0000323297 0.0000085355
0.0000083309 0.0000324028 0.0000083309
0.0000083309 0.0000324028 0.0000083309
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
