cloudn1ne/Mowgli/(threads)

Thread 1 (2022-05-28):

Backup firmware script missing

jessedusty, 2022-05-28:
Hi,

I noticed there isn't a backup firmware script, only the restore. (stm32/original_firmware).

I'm going to try implementing that and send you a PR unless you have a command ready. Also, I'll include some more docs on where to connect the SWD probe to. (I guessed based on the silkscreen so it wasn't that hard, but it would be nice).

Thanks and I hope to help out soon,

Jesse Stevenson

jessedusty, 2022-05-28:
I haven't really worked with openocd yet, and just got a j-link so I can't say I'm experienced. If anyone else wants to jump in feel free

jessedusty, 2022-05-28:
Well that didn't take too long to figure out lol - I still think it's useful to put some more documentation up so others that are looking for it have something

Closed 2022-05-28.

Thread 11 (2022-07-01):

SA900ECO Firmware

dreitakter, 2022-07-01:
Hi.
I found this repo in the OpenMower discord and I am very interested in your solution.
Using the Stock Mainboard to Drive all Motors is awesome.
Can you Tell me where to start If I want to adapt your solution to the Yard force SA900ECO?

I want to do the following:
- disassamble mower
- try to Backup Stock Firmware
- try to flash your mowgli Firmware to the SA900ECO?

I have a ST-link and a Raspberry Pi 3 Here laying around. If your Firmware works with my mower i will purchase the Missing components from your kitlist.

cloudn1ne, 2022-07-01:
As long as you have a Gforce RM-MB-v6.0.0 board this should work as well. With regards to my kitlist - all working so far, but be warned that i dont follow openmowers stack with regards to localisation and navigation as im trying to learn ROS by doing it on my own. Its starting to work, but probably a lot testing needed for it to run realiable.

However there are some ppl in the discord who run mowgli with only slight mods to the openmower stack to make it compatible.

Thread 14 (2022-09-12):

change ROS publisher topic from "odom" to "mowgli/odom"

christophsobel, 2022-09-12:
Mowgli Rover expects topic /mowgli/odom but the stm32 node publishes on topic /odom

In file stm32/ros_usbnode/src/ros/ros_custom/cpp_main.cpp

Line 171:
ros::Publisher pubOdom("odom", &odom_msg);

Should be:
ros::Publisher pubOdom("mowgli/odom", &odom_msg);

cloudn1ne, 2022-09-12:
you are right, atm its rewritten in the launch file - im still experimenting with EKF and dead reckoning, once that works i will fix this (the tf also needs to be broadcasted again)

cloudn1ne, 2022-09-12:
uploaded version with TF for odom_dr->base_link_dr that also has the topic changed to /mowgli/odom

Closed 2022-09-12.

Thread 18 (2023-06-26):

Firmware backup of Panel Firmware of SA900ECO not possible

jak83A, 2023-06-26:
Hey,

i managed to back up the firmware of the SA900ECO's stock mainboard with the raspi, but the Panel is not working.

**Panel PCB Revision:** RM-ECOW-1.0.0
**IC Model**: STM32F030

my yardforce500.cfg is:

`
# source [find interface/stlink.cfg]

interface bcm2835spi

source [find target/stm32f1x.cfg]

#transport select hla_swd

#reset_config srst_only srst_nogate

#program "firmware.bin" 0x08000000 verify reset; shutdown;
`

my **backup_firmware.sh** is:

`openocd -f yardforce500.cfg  -c "init" -c "reset halt" -c " dump_image panel_controller_backup.bin 0x08000000 0x10000" -c "reset" -c shutdown`

The **ERROR** is:

```
Open On-Chip Debugger 0.10.0+dev-01145-g2dfc1ed7 (2023-06-24-13:09)
Licensed under GNU GPL v2
For bug reports, read
        http://openocd.org/doc/doxygen/bugs.html
Info : only one transport option; autoselect 'swd'
Info : BCM2835 SPI SWD driver
Info : SWD only mode enabled
Info : clock speed 31200 kHz
Info : SWD DPIDR 0x0bb11477
Error: Could not find MEM-AP to control the core
Info : Listening on port 3333 for gdb connections
Error: Could not find MEM-AP to control the core
Error: Target not examined, reset NOT asserted!

```

Thread 19 (2023-06-29):

Yardforce NX100i

Strambauer, 2023-06-29:
Hello,
I am going to use Mowgli on my Yardforce NX100i.
The NX100i has a GForce RM-MB-V6.0.0 Mainboard so Mowgli will work (I have already flashed it ;-) ).

I have analysed some hardware pathes wich where not in the scematic of the 500 classic, for example the ultrasonic sensors and the perimeter signal.

During this analyse phase my robot stopt booting and I don't know why.
I know the controler is still working, because I can flash the Mowgli stuff.
So mayby I only destroyed the firmware while measuring.

Do somebody have an firmware backup of an NX Robot?
Or even better the protocol to the panel which i do not have analiese yet.

If someonw want to know some details about the perimeter or the ultrasonic sensors just ask ;-)

Regards
Georg

Pawel-sp9pw, 2023-08-18:
Hi, I'm going to upgrade mine NX100is to mowgli in winter so i could try to backup firmware.

newbyr, 2025-03-06:
Hi.   Do you know which pins follow the perimiter wire?  I want to put a sensor line on this to stop a signal on a modul thanks

Strambauer, 2025-03-06:
> [@Strambauer](https://github.com/Strambauer) Did you succeed in restoring your NX100i original firmware ?

Yes I do succeed in flashing back the orignial firmware. My fault was, that I have caused a short circuit betwen two controler pins. After "cleaning" the pins everything workt as before. The NX100i is working again with the original configuration.

> Hi. Do you know which pins follow the perimiter wire? I want to put a sensor line on this to stop a signal on a modul thanks

I guess I have found the perimeter pins in the circuite diagram after searching for a while. They are not marked so clear, but it sould be easy to find three ignals on the connector. If you do not finde the information I have to search through my notes.

I dropt my mowgli projekt and bought a off the shelf Navimow i108e becaus lag of time.

Thread 21 (2023-10-17):

IMU supported?  10DOF LSM303D + BMP180 + L3G4200D

d0m1n1qu3, 2023-10-17:
Hi
i dont know where to ask :-)

any body know if the cheaper IMU also should work? Is it alo good for our openmower?

https://www.amazon.de/BIlinli-LSM303D-Druckfeld-L3G4200D-Gyroskopmodul-Sensoren/dp/B07VT681HB

Thread 22 (2025-09-06):

Mowgli on a NX60i

UltimateGER, 2025-09-06:
Hi,

I flashed the motherboard and it works fine. However, I can't get rid of the STOP button in the debugger. I checked the contacts and the microswitches work.
The two switches on the upper STOP button are connected to the SIGNAL input. Do I need to change something? Or is this also the case with the Yardforce 500?
Thank you for the great work.

Jens Stephan

` ## EMERGENCY ## - STOP BUTTON (yellow) triggered`
