cloudn1ne/Mowgli/Mounting/GPS Antenna/GPS Eurocard Holder.pdf

# copper side up

# (scale to match outline before drilling !)

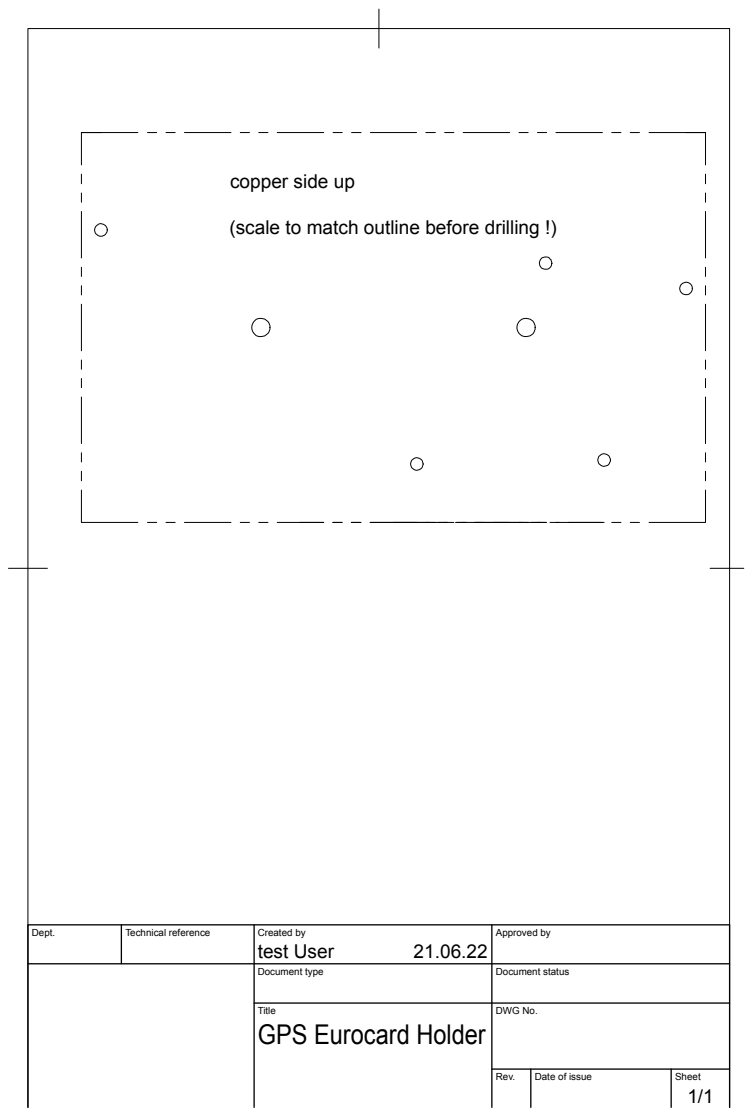
[picture p54: page 1]
Dept.; Technical reference; Created by; Approved by; Document type; Document status; Title; DWG No.; Rev.; Date of issue; Sheet; test User

GPS Eurocard Holder
