cloudn1ne/Mowgli/stm32/ros_usbnode/src/panel.c

/**
  ******************************************************************************
  * @file    panel.c
  * @author  Georg Swoboda <cn@warp.at>
  * @date    21/09/2022
  * @version 1.0.0
  * @brief   panel handling, LED, Buttons
  ******************************************************************************  
  * 
  ******************************************************************************
  */

#include <stdio.h>
#include <string.h>

#include "stm32f1xx_hal.h"
#include "stm32f1xx_hal_uart.h"

#include "panel.h"
#include "board.h"
#include "main.h"

uint16_t buttonstate[PANEL_BUTTON_BYTES];
uint8_t buttonupdated = 0; // 1 if buttonstate was updated by the panel
uint8_t buttoncleared = 0;


uint8_t Led_States[LED_STATE_SIZE];

static uint8_t SendBuffer[256];
static uint8_t ReceiveBuffer[256];
static uint8_t ReceiveIndex = 0;
static uint8_t ReceiveLength;
static uint8_t ReceiveCRC;
// static uint8_t Key_Pressed;
static uint8_t Frame_Received_Panel = 0;
/* per panel type initializers */
#ifdef PANEL_TYPE_YARDFORCE_900_ECO
    const uint8_t KEY_INIT_MSG[] = {0x03, 0x90, 0x28};     
    const uint8_t KEY_ACTIVATE[] = {0x0, 0x0, 0x1};
#endif

#ifdef PANEL_TYPE_YARDFORCE_500_CLASSIC
    const uint8_t KEY_INIT_MSG[] = {0x06, 0x50, 0xe0};    
    const uint8_t KEY_ACTIVATE[] = {0x0, 0x0, 0x1};    
#endif




void PANEL_Send_Message(uint8_t *data, uint8_t dataLength, uint16_t command)
{
    uint8_t ptr = 0;

    SendBuffer[ptr++] = 0x55;
    SendBuffer[ptr++] = 0xaa;
    SendBuffer[ptr++] = dataLength + 0x02;
    SendBuffer[ptr++] = command >> 8;
    SendBuffer[ptr++] = command & 0xff;

    for (int i = 0; i < dataLength; ++i)
    {
        SendBuffer[ptr++] = data[i];
    }

    uint8_t crc = 0;
    for (int i = 0; i < dataLength + 5; ++i)
    {
        crc += SendBuffer[i];
    }
    SendBuffer[dataLength + 5] = crc;

    
  //   msgPrint(SendBuffer, dataLength+6);
#ifdef PANEL_USART_ENABLED
    HAL_UART_Transmit(&PANEL_USART_Handler, SendBuffer, dataLength + 6, 250);
#endif
}



/*
 * called by the UART ISR to process received messages
 * basically we check them for correct frameing and CRC
 * and then extract the data
 */
void PANEL_Handle_Received_Data(uint8_t rcvd_data)
{
    if (ReceiveIndex == 0 && rcvd_data == 0x55) /* PREAMBLE */
    {
        ReceiveCRC = rcvd_data;
        ReceiveBuffer[ReceiveIndex++] = rcvd_data;
    }
    else if (ReceiveIndex == 1 && rcvd_data == 0xAA) /* PREAMBLE */
    {
        ReceiveCRC += rcvd_data;
        ReceiveBuffer[ReceiveIndex++] = rcvd_data;
    }
    else if (ReceiveIndex == 2) /* LEN */
    {
        ReceiveLength = rcvd_data;
        ReceiveBuffer[ReceiveIndex++] = rcvd_data;
        ReceiveCRC += rcvd_data;
    }
    else if (ReceiveIndex >= 3 && ReceiveIndex <= 2 + ReceiveLength) /* DATA bytes */
    {
        ReceiveBuffer[ReceiveIndex++] = rcvd_data;
        ReceiveCRC += rcvd_data;
    }
    else if (ReceiveIndex >= 3 + ReceiveLength) /* CRC byte */
    {
        if (ReceiveCRC == rcvd_data)
        {
           // Key_Pressed = 1;
            Frame_Received_Panel = 1;
        }
        ReceiveIndex = 0;
    }
}

/*
 * Initialize HW, USART and send init sequence to panel
 */
void PANEL_Init(void)
{    
#ifdef PANEL_USART_ENABLED
    GPIO_InitTypeDef GPIO_InitStruct = {0};

    // enable port and usart clocks
    PANEL_USART_GPIO_CLK_ENABLE();

    // RX
    GPIO_InitStruct.Pin = PANEL_USART_RX_PIN;
    GPIO_InitStruct.Mode = GPIO_MODE_INPUT;
    GPIO_InitStruct.Pull = GPIO_NOPULL;
    GPIO_InitStruct.Speed = GPIO_SPEED_HIGH;
    HAL_GPIO_Init(PANEL_USART_RX_PORT, &GPIO_InitStruct);

    // TX
    GPIO_InitStruct.Pin = PANEL_USART_TX_PIN;
    GPIO_InitStruct.Mode = GPIO_MODE_AF_PP;
    // GPIO_InitStruct.Pull = GPIO_PULLUP;
    GPIO_InitStruct.Speed = GPIO_SPEED_HIGH;
    HAL_GPIO_Init(PANEL_USART_TX_PORT, &GPIO_InitStruct);

    PANEL_USART_USART_CLK_ENABLE();

    PANEL_USART_Handler.Instance = PANEL_USART_INSTANCE;      // USART1
    PANEL_USART_Handler.Init.BaudRate = 115200;               // Baud rate
    PANEL_USART_Handler.Init.WordLength = UART_WORDLENGTH_8B; // The word is  8  Bit format
    PANEL_USART_Handler.Init.StopBits = USART_STOPBITS_1;     // A stop bit
    PANEL_USART_Handler.Init.Parity = UART_PARITY_NONE;       // No parity bit
    PANEL_USART_Handler.Init.HwFlowCtl = UART_HWCONTROL_NONE; // No hardware flow control
    PANEL_USART_Handler.Init.Mode = USART_MODE_TX_RX;         // Transceiver mode

    HAL_UART_Init(&PANEL_USART_Handler); // HAL_UART_Init() Will enable UART1

    HAL_NVIC_SetPriority(PANEL_USART_IRQ, 0, 0);
	HAL_NVIC_EnableIRQ(PANEL_USART_IRQ);     


    memset(Led_States, 0x0, LED_STATE_SIZE);       // all LEDs OFF
    // Initialize Panel Sequence
    PANEL_Send_Message(NULL, 0, 0xffff);
    HAL_Delay(100);
    PANEL_Send_Message(NULL, 0, 0xfffe);
    HAL_Delay(100);    
    PANEL_Send_Message((uint8_t*)KEY_INIT_MSG, sizeof(KEY_INIT_MSG), 0xfffd);
    HAL_Delay(100);
    PANEL_Send_Message(NULL, 0, 0xfffb);
    HAL_Delay(100);
    // knight rider <3
    uint8_t i,j=0;
    for (j=0;j<2;j++)
    {
        for (i=4;i<7;i++)
        {
            memset(Led_States, 0x0, LED_STATE_SIZE);
            PANEL_Set_LED(i, PANEL_LED_ON);
            PANEL_Send_Message(Led_States, sizeof(Led_States), LED_CMD);     
            PANEL_Send_Message((uint8_t*)KEY_ACTIVATE, sizeof(KEY_ACTIVATE), 0x5084);
            HAL_Delay(50);
        }
        for (i=7;i>=4;i--)
        {
            memset(Led_States, 0x0, LED_STATE_SIZE);
            PANEL_Set_LED(i, PANEL_LED_ON);
            PANEL_Send_Message(Led_States, sizeof(Led_States), LED_CMD);     
            PANEL_Send_Message((uint8_t*)KEY_ACTIVATE, sizeof(KEY_ACTIVATE), 0x5084);
            HAL_Delay(50);
        }
    }
    // all off
    HAL_Delay(50);
    memset(Led_States, 0x0, LED_STATE_SIZE);    
    PANEL_Send_Message(Led_States, sizeof(Led_States), LED_CMD);     
    PANEL_Send_Message((uint8_t*)KEY_ACTIVATE, sizeof(KEY_ACTIVATE), 0x5084);

#endif
}

void PANEL_Set_LED(uint8_t led, PANEL_LED_STATE state)
{
    if (led >= 0 && led < LED_STATE_SIZE)
    {
        switch (state)
        {
        case PANEL_LED_OFF:
            Led_States[led] = 0x00;
            break;

        case PANEL_LED_ON:
            Led_States[led] = 0x10;
            break;

        case PANEL_LED_FLASH_SLOW:
            Led_States[led] = 0x20;
            break;

        case PANEL_LED_FLASH_FAST:
            Led_States[led] = 0x22;
            break;
        }
    }
}

/*
 * feed panel messages to uart
 * needs to be called regularly or led states will timeout 
 */
void PANEL_Tick(void)
{   
     if (Frame_Received_Panel == 1)
     {
      if (ReceiveBuffer[0] == 0x55 && ReceiveBuffer[1] == 0xaa && ReceiveBuffer[3] == 0x50) // & ReceiveBuffer[2]==0x02  & ReceiveBuffer[4]==0x00)
      {
        
           //  debug_printf("%x %x %x | %x %x %x \r\n",ReceiveBuffer[2],ReceiveBuffer[3],ReceiveBuffer[4], ReceiveBuffer[5], ReceiveBuffer[6], ReceiveBuffer[7]);
            /* if (ReceiveBuffer[5]==0x02) debug_printf("key: timer\r\n");
            if (ReceiveBuffer[6]==0x02) debug_printf("key: S1\r\n");
            if (ReceiveBuffer[7]==0x02) debug_printf("key: S2\r\n");
            if (ReceiveBuffer[8]==0x02) debug_printf("key: Lock\r\n");
            if (ReceiveBuffer[9]==0x02) debug_printf("key: OK\r\n");
            if (ReceiveBuffer[10]==0x02) debug_printf("key: Mon\r\n");
            if (ReceiveBuffer[11]==0x02) debug_printf("key: Tue\r\n");
            if (ReceiveBuffer[12]==0x02) debug_printf("key: Wed\r\n");
            if (ReceiveBuffer[13]==0x02) debug_printf("key: Thu\r\n");
            if (ReceiveBuffer[14]==0x02) debug_printf("key: Fri\r\n");
            if (ReceiveBuffer[15]==0x02) debug_printf("key: Sat\r\n");
            if (ReceiveBuffer[16]==0x02) debug_printf("key: Sun\r\n");
            */
            if ((ReceiveBuffer[5]&0x1) == 0) // any button pressed
            {
               for(int button_byte=0;button_byte < PANEL_BUTTON_BYTES;button_byte++)
                {
               
                    buttonstate[button_byte] = ReceiveBuffer[button_byte+5];//&0x3;
                    buttonupdated = 1;
                    buttoncleared = 0;
                }
            }
            else
            {   // no button pressed
                if (!buttoncleared) // latch to detect first button release only
                {
                    for(int button_byte=0;button_byte < PANEL_BUTTON_BYTES;button_byte++)
                    {
                      buttonstate[button_byte] = 0;
                    }
                    buttonupdated = 1;
                    buttoncleared = 1;
                }
            }
    
      }
      Frame_Received_Panel=0;
     }
     

    // uncomment to flash charging led as a test
    // PANEL_Set_LED(PANEL_LED_CHARGING, PANEL_LED_FLASH_FAST);
    
#ifdef PANEL_USART_ENABLED    
     PANEL_Send_Message(Led_States, sizeof(Led_States), LED_CMD);     
     PANEL_Send_Message((uint8_t*)KEY_ACTIVATE, sizeof(KEY_ACTIVATE), 0x5084);     
#endif
}
/*
int PANEL_Get_Key_Pressed(void)
{
    uint8_t result = Key_Pressed;
    Key_Pressed = 0;
    return result;
}
*/
