cloudn1ne/Mowgli/stm32/ros_usbnode/src/ros/ros_lib/mowgli/GetCfg.h

#ifndef _ROS_SERVICE_GetCfg_h
#define _ROS_SERVICE_GetCfg_h
#include <stdint.h>
#include <string.h>
#include <stdlib.h>
#include "ros/msg.h"

namespace mowgli
{

static const char GETCFG[] = "mowgli/GetCfg";

  class GetCfgRequest : public ros::Msg
  {
    public:
      typedef const char* _name_type;
      _name_type name;
      enum { TYPE_INT32 = 0 };
      enum { TYPE_UINT32 = 1 };
      enum { TYPE_FLOAT = 2 };
      enum { TYPE_DOUBLE = 3 };
      enum { TYPE_STRING = 4 };
      enum { TYPE_BARRAY = 5 };
      enum { STATUS_OK = 1 };
      enum { STATUS_FAIL = 0 };

    GetCfgRequest():
      name("")
    {
    }

    virtual int serialize(unsigned char *outbuffer) const override
    {
      int offset = 0;
      uint32_t length_name = strlen(this->name);
      varToArr(outbuffer + offset, length_name);
      offset += 4;
      memcpy(outbuffer + offset, this->name, length_name);
      offset += length_name;
      return offset;
    }

    virtual int deserialize(unsigned char *inbuffer) override
    {
      int offset = 0;
      uint32_t length_name;
      arrToVar(length_name, (inbuffer + offset));
      offset += 4;
      for(unsigned int k= offset; k< offset+length_name; ++k){
          inbuffer[k-1]=inbuffer[k];
      }
      inbuffer[offset+length_name-1]=0;
      this->name = (char *)(inbuffer + offset-1);
      offset += length_name;
     return offset;
    }

    virtual const char * getType() override { return GETCFG; };
    virtual const char * getMD5() override { return "5ae17f7829b70d30a6eba9d2fe345c0c"; };

  };

  class GetCfgResponse : public ros::Msg
  {
    public:
      typedef uint8_t _type_type;
      _type_type type;
      uint32_t data_length;
      typedef uint8_t _data_type;
      _data_type st_data;
      _data_type * data;
      typedef uint8_t _status_type;
      _status_type status;

    GetCfgResponse():
      type(0),
      data_length(0), st_data(), data(nullptr),
      status(0)
    {
    }

    virtual int serialize(unsigned char *outbuffer) const override
    {
      int offset = 0;
      *(outbuffer + offset + 0) = (this->type >> (8 * 0)) & 0xFF;
      offset += sizeof(this->type);
      *(outbuffer + offset + 0) = (this->data_length >> (8 * 0)) & 0xFF;
      *(outbuffer + offset + 1) = (this->data_length >> (8 * 1)) & 0xFF;
      *(outbuffer + offset + 2) = (this->data_length >> (8 * 2)) & 0xFF;
      *(outbuffer + offset + 3) = (this->data_length >> (8 * 3)) & 0xFF;
      offset += sizeof(this->data_length);
      for( uint32_t i = 0; i < data_length; i++){
      *(outbuffer + offset + 0) = (this->data[i] >> (8 * 0)) & 0xFF;
      offset += sizeof(this->data[i]);
      }
      *(outbuffer + offset + 0) = (this->status >> (8 * 0)) & 0xFF;
      offset += sizeof(this->status);
      return offset;
    }

    virtual int deserialize(unsigned char *inbuffer) override
    {
      int offset = 0;
      this->type =  ((uint8_t) (*(inbuffer + offset)));
      offset += sizeof(this->type);
      uint32_t data_lengthT = ((uint32_t) (*(inbuffer + offset))); 
      data_lengthT |= ((uint32_t) (*(inbuffer + offset + 1))) << (8 * 1); 
      data_lengthT |= ((uint32_t) (*(inbuffer + offset + 2))) << (8 * 2); 
      data_lengthT |= ((uint32_t) (*(inbuffer + offset + 3))) << (8 * 3); 
      offset += sizeof(this->data_length);
      if(data_lengthT > data_length)
        this->data = (uint8_t*)realloc(this->data, data_lengthT * sizeof(uint8_t));
      data_length = data_lengthT;
      for( uint32_t i = 0; i < data_length; i++){
      this->st_data =  ((uint8_t) (*(inbuffer + offset)));
      offset += sizeof(this->st_data);
        memcpy( &(this->data[i]), &(this->st_data), sizeof(uint8_t));
      }
      this->status =  ((uint8_t) (*(inbuffer + offset)));
      offset += sizeof(this->status);
     return offset;
    }

    virtual const char * getType() override { return GETCFG; };
    virtual const char * getMD5() override { return "51f72d8723bf2c6ee63f360ed75786d8"; };

  };

  class GetCfg {
    public:
    typedef GetCfgRequest Request;
    typedef GetCfgResponse Response;
  };

}
#endif
