cloudn1ne/Mowgli/stm32/ros_usbnode/include/emergency.h

#ifndef __EMERGENCY_H
#define __EMERGENCY_H

#include <stdint.h>

#ifdef __cplusplus
extern "C" {
#endif

uint8_t Emergency_State(void);
int Emergency_Tilt(void);
int Emergency_StopButtonYellow(void);
int Emergency_StopButtonWhite(void);
int Emergency_WheelLiftBlue(void);
int Emergency_WheelLiftRed(void);
int Emergency_LowZAccelerometer(void);
void EmergencyController(void);
void Emergency_Init(void);

#ifdef __cplusplus
}
#endif

#endif  /* __EMERGENCY_H */
