cloudn1ne/Mowgli/stm32/ros_usbnode/src/ros/ros_lib/mowgli/magnetometer.h

#ifndef _ROS_mowgli_magnetometer_h
#define _ROS_mowgli_magnetometer_h

#include <stdint.h>
#include <string.h>
#include <stdlib.h>
#include "ros/msg.h"

namespace mowgli
{

  class magnetometer : public ros::Msg
  {
    public:
      typedef float _x_type;
      _x_type x;
      typedef float _y_type;
      _y_type y;
      typedef float _z_type;
      _z_type z;

    magnetometer():
      x(0),
      y(0),
      z(0)
    {
    }

    virtual int serialize(unsigned char *outbuffer) const override
    {
      int offset = 0;
      offset += serializeAvrFloat64(outbuffer + offset, this->x);
      offset += serializeAvrFloat64(outbuffer + offset, this->y);
      offset += serializeAvrFloat64(outbuffer + offset, this->z);
      return offset;
    }

    virtual int deserialize(unsigned char *inbuffer) override
    {
      int offset = 0;
      offset += deserializeAvrFloat64(inbuffer + offset, &(this->x));
      offset += deserializeAvrFloat64(inbuffer + offset, &(this->y));
      offset += deserializeAvrFloat64(inbuffer + offset, &(this->z));
     return offset;
    }

    virtual const char * getType() override { return "mowgli/magnetometer"; };
    virtual const char * getMD5() override { return "4a842b65f413084dc2b10fb484ea7f17"; };

  };

}
#endif
