cloudn1ne/Mowgli/(commit log)

2022-05-21 inital commit
    [HC245.sch, J18 (Red Connector).sch, J5 (Signal).sch, J6 (Control Panel).sch, Mowgli.kicad_pcb, Mowgli.sch, PAC5210QS.sch, PAC5223QM.sch]
2022-05-21 added finger
2022-05-21 updated J18
    [J18 (Red Connector).sch, Mowgli.sch]
2022-05-22 added LIS example code
    [HC245.sch, J18 (Red Connector).sch, J5 (Signal).sch, J6 (Control Panel).sch, Mowgli.sch, PAC5210QS.sch, PAC5223QM.sch, SPI_I2C.sch]
2022-05-22 added shorted connectors
2022-05-24 updated Kicad with Charge/Battery Circuit
    [HC245.sch, J18 (Red Connector).sch, J5 (Signal).sch, J6 (Control Panel).sch, Mowgli.sch, PAC5210QS.sch, PAC5223QM.sch, SPI_I2C.sch]
2022-05-24 added PA3 ADC input pin
    [Mowgli.sch, STM32F103.sch, power_charge.sch]
2022-05-25 added in/out ports that could be found in ghidra
    [STM32F103.sch]
2022-05-25 PA2,PA3 are used for Charging and Battery Voltage monitoring - added stm32 code and updated KiCad
    [HC245.sch, J18 (Red Connector).sch, J5 (Signal).sch, Mowgli.sch, PAC5210QS.sch, PAC5223QM.sch, SPI_I2C.sch, STM32F103.sch]
2022-05-26 updated kicad
    [HC245.sch, Mowgli.sch, power_charge.sch]
2022-05-26 added battery pics
2022-05-28 charge_pwm topic added
2022-05-29 fixed include files panel code now works
    [cpp_main.cpp, panel.c, panel.h]
2022-05-29 added LED_CMD
2022-05-30 added /charging_state and separated charge controler from charge status
2022-05-30 added pic for swd pin headers and howto dump panel firmware
    [yardforce500.cfg]
2022-06-03 added J18 SPI3 pins
    [HC245.sch, J1.sch, J18 (Red Connector).sch, J5 (Signal).sch, J6 (Control Panel).sch, Mowgli.sch, PAC5210QS.sch, PAC5223QM.sch]
2022-06-03 added soft i2c and pololu IMU reading support
    [STM32F103.sch]
2022-06-04 normalized IMU data to ROS defaults
2022-06-04 soft i2c to the max ...
2022-06-05 moved to USART DMA, drivemotors working, master tx working
2022-06-05 added covariance to imu data
2022-06-06 fixed gauss factor for imuv10
    [altimu-10v5.c, cpp_main.cpp, imu.c]
2022-06-06 added various mounting files
    [IMU10v5CarrierYF500.stl, Raspi Brace.stl, Raspi Camera Mount YF500.stl]
2022-06-06 better STL for camera mounting (only works with top cover OFF)
    [Raspi Camera Mount YF500.stl]
2022-06-06 Improve charging logic when battery is powering rpi
    My battery never reaches 29.4V while powering the rpi. Use the charge
    current instead to determine when charging is complete.
2022-06-06 Fix direction of travel for positive linear.x
    [cpp_main.cpp]
2022-06-07 added more details to panel J6 connector, and reversed rain sensor (STM32 PE2)
    [HC245.sch, J1.sch, J18 (Red Connector).sch, J5 (Signal).sch, J6 (Control Panel).sch, Mainboard Rain.sch, Mowgli.sch, PAC5210QS.sch]
2022-06-07 GPS antenna mounting
2022-06-07 added some datasheets, kicad updates
    [HC245.sch, J1.sch, J18 (Red Connector).sch, J5 (Signal).sch, J6 (Control Panel).sch, Mainboard Rain.sch, Mainboard Safety.sch, Mowgli.sch]
2022-06-08 Fix angular velocity conversion
    Should multiply by radius to convert rads/s to m/2. Center of the wheel
    base is point of rotation so radius = WHEEL_BASE/2
    [cpp_main.cpp]
2022-06-13 Update README.md
    added fw details for replacement YF500 Classic board that is from 2019
2022-06-13 added onboard BEEPER
    [HC245.sch, J1.sch, J18 (Red Connector).sch, J5 (Signal).sch, J6 (Control Panel).sch, Mainboard Beeper.sch, Mainboard Rain.sch, Mainboard Safety.sch]
2022-06-15 reversed mechanical tilt and accelerometer circuit
    [HC245.sch, J6 (Control Panel).sch, Mainboard Safety.sch, Mowgli.sch, PAC5223QM.sch, STM32F103.sch]
2022-06-15 added Panel Eliminator
    [HC245.sch, J18 (Red Connector).sch, Mainboard Safety.sch, Mowgli.sch, STM32F103.sch]
2022-06-15 added double chirp when mainloop is reached, perma chirping when error handler triggers
    [main.h]
2022-06-15 reverted dir changes, front is castor wheels
    [cpp_main.cpp]
2022-06-16 Track encoder ticks similar to xesc
    Add a total tick count per wheel. Try to compensate for quirks in the
    data returned from the motor controller.
2022-06-16 Add emergency sensor handling
    Use similar logic to OpenMower for emergency sensor handling.
    Use lifted LED to signal low level emergency.
    Hold play button to reset.
    Also stop motors when cmd_vel messages are not being received, similar
    to OpenMower logic.
    [board.h, cpp_main.cpp, main.h]
2022-06-17 switched imu back to raw values, calibration done in imu_gmadwick and disabled publishing the TF
2022-06-17 moved i2c to dedicated files, decoupled last vel cmd from last blade cmd timeout
2022-06-17 onboard imu, and tilt protection working
2022-06-17 onboard accelerometer handled by EmergencyController()
2022-06-17 R195 is not populated on all boards, (white hall sensor cable for stop button)
    [Mainboard Beeper.sch, Mainboard Safety.sch]
2022-06-19 imu example scripts
    [Raspi Brace.stl]
2022-06-19 added pio config to remote programm via ssh/openocd
    [prog.cfg, yardforce500.cfg]
2022-06-19 moved /imu_onboard/temp to chatter_handler as 1sec update rate is enough for temp
2022-06-19 added /cmd_reboot (bool) topic to reboot the stm32 + disable tilt/lift sensors via #define I_DONT_NEED_MY_FINGERS
    [board.h, cpp_main.cpp]
2022-06-20 added variance and frameid to onboard imu temp reading (rviz needs this)
2022-06-20 added euro pcb
2022-06-22 imu msgs have more accurate time stamps
2022-06-22 updated STLs
    [MeanWell-DCDC-Converter.stl, Raspi Brace.stl]
2022-06-22 add bootup calibration for onboard and ext IMU
2022-06-23 added IMU auto calibration on startup - and calculating variance on the IMU parameters
2022-06-23 moved dcdc stl into subfolder
    [MeanWell-DCDC-Converter.stl]
2022-06-24 improved IMU mount
    [IMU10v5CarrierYF500.stl]
2022-06-25 added ATX extension to DCDC wiring
2022-06-25 added IMU & Debug serial mounting info
2022-06-29 added IMU Mag calibration (transform and bias)
2022-06-30 testing mag calibration routines for ext IMU
    [Stlink_holder_v5.stl, Stlink_holder_v6.stl]
2022-07-03 added cam mount stls
    [Raspi Camera Mount YF500 Insert.stl, Raspi Camera Mount YF500.stl]
2022-07-04 rain sensor test code
2022-07-04 imu cal with ros imu cal
2022-07-06 merged buttonstates topic
2022-07-06 merged button changes
2022-07-09 Delete Stlink_holder_v5.stl
    use v6 instead
    [Stlink_holder_v5.stl]
2022-07-09 added some pics
    [Stlink_holder_v5.stl]
2022-07-09 updated ublox mounting
2022-07-09 added cam mounting info
2022-07-10 added custom panel fw for YF500C
    [configure-trace.cfg, gd32f303.cfg, yardforce500.cfg]
2022-07-11 panel updates
    [J6 (Control Panel).sch]
2022-07-14 charge controller update with more accurate formular for charge current and capping cc at 1.0 amps
2022-07-14 kicad cleanup
    [STM32F103.sch, power_charge.sch]
2022-07-16 kicad boot0 pin update
    [STM32F103.sch]
2022-07-16 fw dump fix
    [yardforce500.cfg]
2022-07-17 CfgFlash Srvs working, and IMU reads mag soft/hard calibration from CfgFlash on bootup
2022-07-17 split nbts and increased frequency for odom and imu
2022-07-18 switched /odom to encoder ticks (instead of reported velocity)
2022-07-18 re-enabled onboard IMU
2022-07-18 moved odom dth calc to use distances instead of velocities
2022-09-14 reduced pwm frequency for charge controller to 50hz (from 100hz) and switching off TF4 while charging
2022-09-14 disabled debug print
2022-09-14 lowered charge voltage to 29.2V to avoid BMS error triggering - enabled TF4 again for a test
    [cpp_main.cpp]
2022-09-15 back to 29.4 as 29.2 charge end voltage didnt fix the BMS turning off charging ahead of time
2022-09-15 mowgli/status msgs back to 4Hz
2022-09-17 added Flowcharts for behaviours
2022-09-19 Update README.md
    added uart5 howto
2022-09-20 switch to 400khz I2C frequency for IMU added version and blade motor status to mowgli/status added major, branch, minor version to mowgli/status added watchdog code (but disabled) from nekraus
2022-09-20 backported DMA based blade and drive motor controller from Nekraus
2022-09-21 merged DMA based drive motor and blade motor controller from Nekraus - enabled blademotor feedback via mowgli/status
2022-09-21 left and right power valued published via mowgli/status
2022-09-25 added Led with chirp service
2022-09-25 led fix
2022-09-25 version set to 1.0.1 (GPS Led Status)
2022-09-25 rm stm32/ros_usbnode/platformio.iniy
2022-09-25 clear all led bitflag added (0x40)
2022-10-02 Added instructions for alternative camera module
    [Raspi Big Camera Mount YF500 Insert.stl, Raspi Big Camera Mount YF500.stl]
2022-10-02 Added link to alternative camera module instructions
2022-10-02 Corrected link to alternative camera module instructions
2022-10-08 version 1.0.1 ext imu can be switched off via board.h blade motor can be disabled via board.h soft i2c timing loop fix (Nekraus)
    [Raspi Big Camera Mount YF500 Insert.stl, Raspi Big Camera Mount YF500.stl]
