cloudn1ne/Mowgli/Mounting/IMU/imu_mounted.jpg

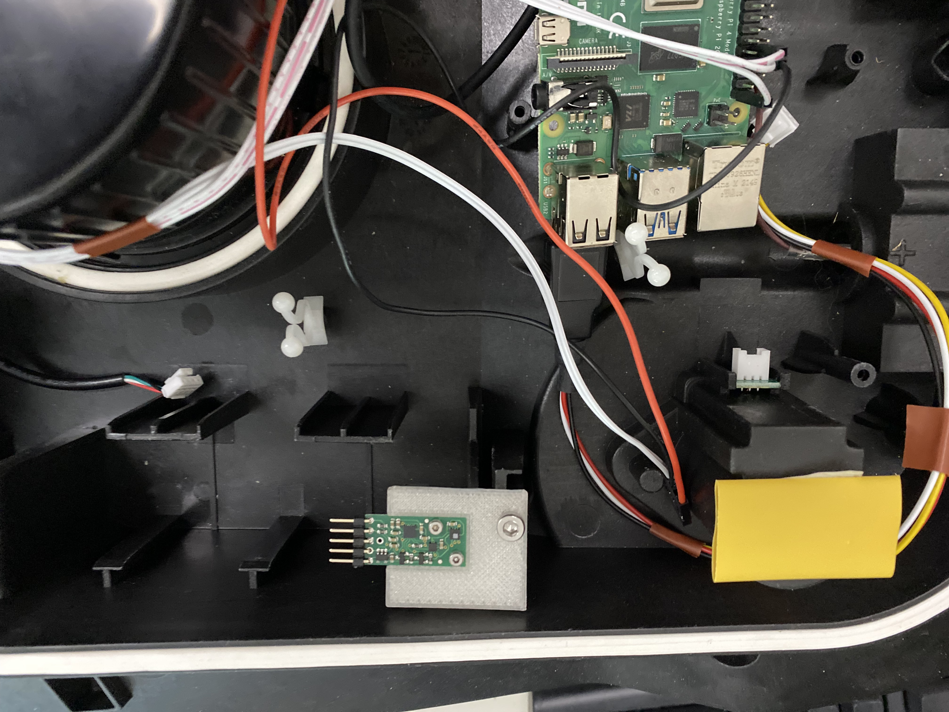
[picture p27: Mounting/IMU/imu_mounted.jpg]
Mounting/IMU/imu_mounted.jpg
