cloudn1ne/Mowgli/Mounting/Raspi/raspi_mount2.jpg

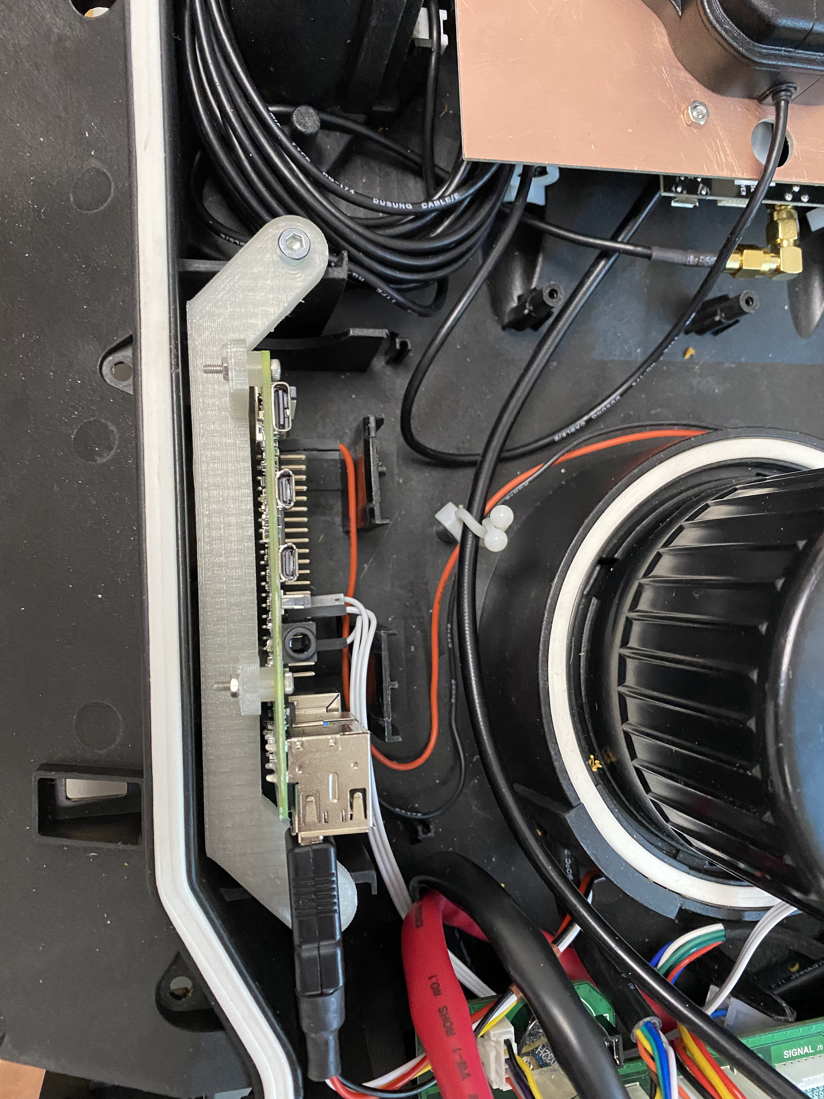
Mounting/Raspi/raspi_mount2.jpg
